shyndman/esp-theoretical-thermostat/openspec/changes/improve-audio-quality/specs/microphone-streaming/spec.md

## MODIFIED Requirements
### Requirement: Microphone Streaming Configuration
The system SHALL provide build-time settings that enable or disable microphone streaming and allow wiring adjustments for the PDM microphone.

#### Scenario: Menuconfig options available
- **WHEN** `CONFIG_THEO_CAMERA_ENABLE = y`
- **THEN** the "Camera & Streaming" menu exposes `CONFIG_THEO_MICROPHONE_ENABLE`, `CONFIG_THEO_MIC_PDM_CLK_GPIO`, and `CONFIG_THEO_MIC_PDM_DATA_GPIO`.
- **AND** disabling `CONFIG_THEO_MICROPHONE_ENABLE` omits microphone capture code and suppresses the audio track from the WebRTC offer.

#### Scenario: Default configuration values
- **WHEN** the firmware is built using the repository `sdkconfig.defaults`
- **THEN** `CONFIG_THEO_MICROPHONE_ENABLE` defaults to `n` until audio is validated on hardware
- **AND** the clock/data GPIO defaults remain 12 and 9 so existing harnesses require no extra wiring.

### Requirement: PDM Microphone Capture Path
When microphone streaming is enabled the firmware SHALL dedicate I2S0 to the MEMS PDM microphone, capture 16-bit mono PCM at 16 kHz, and feed 20 ms frames into the esp_capture pipeline.

#### Scenario: Hardware capture configured
- **WHEN** `CONFIG_THEO_MICROPHONE_ENABLE = y`
- **THEN** I2S0 is initialized in PDM RX mode with CLK on `CONFIG_THEO_MIC_PDM_CLK_GPIO` and DIN on `CONFIG_THEO_MIC_PDM_DATA_GPIO`
- **AND** the capture source produces signed 16-bit mono PCM frames at 16 kHz for downstream encoding.

#### Scenario: Frame cadence
- **WHEN** the capture pipeline requests microphone samples
- **THEN** the audio source emits 320-sample buffers (~20 ms at 16 kHz) so the Opus encoder receives consistent frame sizes without extra resampling stages.

#### Scenario: Mic disabled
- **WHEN** `CONFIG_THEO_MICROPHONE_ENABLE = n`
- **THEN** no I2S0/PDM hardware is initialized and the WebRTC publisher operates video-only.

### Requirement: WebRTC Audio Lifecycle
The WebRTC publisher SHALL stream live microphone audio over the advertised Opus track, keep audio/video lifecycles aligned, and isolate failures so video can continue if the mic breaks.

#### Scenario: Audio starts and stops with WebRTC
- **WHEN** the esp_webrtc peer connection transitions to CONNECTED and audio streaming is enabled
- **THEN** the esp_capture sink starts producing 16 kHz, 20 ms Opus frames, and the send-only audio track carries those samples until the peer disconnects
- **AND** when the peer disconnects the audio capture task stops, releases I2S0, and the Opus track is removed from SDP until audio is re-enabled.

#### Scenario: Failure isolation
- **WHEN** microphone initialization, capture, or Opus encoding fails while video is healthy
- **THEN** the firmware logs the error, keeps video streaming, and does not attempt to restart audio until the module is reinitialized (or the device reboots).

#### Scenario: Single publisher
- **WHEN** a second peer attempts to subscribe to the WebRTC stream
- **THEN** the system preserves the existing single-session behaviour (the first peer keeps audio/video, others are rejected) so bandwidth and heap usage remain bounded.
