shyndman/esp-theoretical-thermostat/openspec/changes/add-led-notifications/design.md

# Design: LED diffuser notifications

## Hardware / driver assumptions
- The strip is fifty WS2812-class pixels with an RGB subpixel layout. We will rely on Espressif's `led_strip` component (RMT backend) to generate the timings, configured for 10 MHz and GRB ordering on `CONFIG_THEO_LED_STRIP_GPIO` (default 33).
- The diffuser expects a uniform wash, so the driver always writes the same color to every pixel. This keeps RAM footprint tiny (one `led_strip_set_pixel` call per LED) and avoids needing animation buffers.
- Brightness is implicit in the provided RGB hex values; we scale them during fades by multiplying components before each refresh.

## Initialization order
- `thermostat_leds_init()` becomes the very first subsystem invoked inside `app_main`, before BSP display/touch setup, so the blue boot pulse serves as an immediate "sign of life" while the LCD stack is still configuring.
- If initialization succeeds and LEDs are enabled, `thermostat_led_status_booting()` starts the 0.33 Hz pulse immediately, bypassing quiet-hours checks until SNTP delivers time (defined as `time_sync_wait_for_sync(0)` returning true). Once the clock is accurate—or we exit boot without ever syncing—subsequent LED requests go through the shared quiet-hours helper.

## Service layers
1. **`thermostat_leds`**: owns initialization, enable flag, quiet-hours gating hooks, and primitive effects.
   - Effects:
     - `thermostat_leds_pulse(color, hz)`: sets a 50% duty oscillation implemented via an esp_timer (10 ms tick) that rewrites all pixels and calls `led_strip_refresh()` every tick.
     - `thermostat_leds_solid_fade(color, fade_ms)`: ramp from off to color across evenly spaced steps (≥10 per fade) before holding.
     - `thermostat_leds_off_fade(fade_ms)`: ramp from current color to off using the same stepping logic.
   - Any new effect call cancels the currently running timer/effect immediately before arming the replacement so controllers do not need to coordinate sequencing.
   - When LEDs are disabled or the quiet-hours helper denies output, the service short-circuits and reports the error so controllers can skip scheduling timers.
2. **`thermostat_led_status`**: high-level state machine that listens to boot lifecycle + HVAC dataplane events.
   - Boot path: `app_main` calls `thermostat_led_status_booting()` immediately after LED init (before LVGL) to begin the 0.33 Hz blue pulse; once the splash is destroyed it calls `thermostat_led_status_boot_complete()` to run the 1 s fade-up + hold + 100 ms fade-out.
  - HVAC path: MQTT dataplane toggles `thermostat_led_status_set_hvac(bool heating, bool cooling)` immediately after it updates the UI view-model (same callsite as `thermostat_update_hvac_status_group()`). Heating wins when both true (defensive), with cooling selected only when heating is false.
   - Idle/off: when no scenarios apply, LEDs fade off over 100 ms via `thermostat_leds_off_fade(100)`.

## Shared quiet-hours helper
- Introduce `main/thermostat/application_cues.{c,h}` with the API:
  - `esp_err_t thermostat_application_cues_check(const char *cue_name, bool feature_enabled);` → centralized helper that every "application cue" (user-facing audio/LED signal) calls to confirm it may run. It wraps the relevant build flag (`feature_enabled`), SNTP sync (via `time_sync_wait_for_sync(0)`), and quiet-window math (driven by neutral `CONFIG_THEO_QUIET_HOURS_START_MINUTE` / `_END_MINUTE`). Returns `ESP_OK` when cues may run, `ESP_ERR_NOT_SUPPORTED` when the build flag is off, and `ESP_ERR_INVALID_STATE` for quiet hours or unsynced clocks. `cue_name` is used in logs so suppression reasons stay readable.
  - Helper functions live alongside a static struct caching quiet-window config so audio and LEDs stop duplicating minute/interval math. There is no background polling—quiet hours are enforced strictly at request time.
- **Existing code changes:** `audio_boot.c` replaces `audio_policy_check()` with calls into `thermostat_application_cues_check("Boot chime", CONFIG_THEO_AUDIO_ENABLE)` so the quiet logic is centralized. The local helper functions (`quiet_hours_active`, `log_quiet_hours_skip`, etc.) move into `application_cues.c` along with the renamed neutral Kconfig symbols.
- **LED integration:** `thermostat_leds_*` APIs call the helper before arming timers once the clock is valid; if the helper returns non-OK they drop the request (leaving any existing effect untouched) and short-circuit. During early boot, LEDs bypass the helper so the blue pulse still runs, then opt into the helper as soon as `time_sync_wait_for_sync(0)` returns true (or boot exits after logging the sync failure).
- Quiet-hours configuration lives under the new neutral Kconfig entries shared by audio + LEDs, and there is no requirement to resume cues automatically when quiet hours end—the caller must issue a fresh request if it still wants output.

## Build flag behavior
- `CONFIG_THEO_LED_ENABLE` gates initialization entirely. When false, `thermostat_leds_init()` returns `ESP_ERR_NOT_SUPPORTED`, `thermostat_led_status_booting()` logs INFO that LEDs are disabled, and all subsequent requests become NOPs without allocating RAM or timers.

## Failure & recovery
- Driver init failures bubble up with `ESP_LOGE` but do not block boot; controllers treat LEDs as optional.
