shyndman/esp-theoretical-thermostat/docs/manual-test-plan.md

# Manual Test Plan

MQTT placeholders used below:
- `<HABase>` = normalized `CONFIG_THEO_HA_BASE_TOPIC` (blank falls back to `homeassistant`; trailing `/` is trimmed)
- `<TheoBase>` = normalized `CONFIG_THEO_THEOSTAT_BASE_TOPIC` (default `theostat`)
- `<TheoBase>/<slug>` = canonical Theo device root

## Dataplane Validation
1. Connect the thermostat to the Home Assistant broker specified by `CONFIG_THEO_MQTT_HOST` and ensure the dataplane subscriptions are accepted.
2. Drag either setpoint slider on the device and release to commit. Watch the serial log for the `temperature_command` JSON publish and note the QoS1 message id.
3. Verify via `mosquitto_sub -t "<TheoBase>/<slug>/climate/temperature_command" -v` (or the broker's MQTT debug console) that the publishes land; the thermostat updates immediately and no timeout rollback should occur.
4. Observe the UI to ensure slider positions, weather, room, and HVAC indicators match the inbound MQTT payloads; malformed payloads should log warnings and show the ERR/error-color states without crashing.

## Remote Setpoint Animation
1. Let the panel enter idle sleep, then publish a new `target_temp_high` (cooling) via MQTT while monitoring logs. Confirm the controller logs the wake request, backlight-light transition, 1000 ms pre-delay, and that both tracks/labels animate toward the new value over ~1600 ms while the numerals show intermediate temperatures.
2. While the first animation is running, publish at least two additional setpoint updates (mix of `target_temp_low/high`). Confirm only the latest payload per burst runs next, there is no extra pre-delay, and the logs note the pending-session handoffs.
3. After the final animation, ensure the log reports a 1000 ms hold followed by `backlight_manager_schedule_remote_sleep(...)` only if the first wake was consumed and no other touches occurred. Trigger a touch during the hold to verify the auto-sleep is skipped.

## Boot Transition & UI Entrance Animations
1. Reboot the thermostat and observe the boot ceremony: sparkle drain → LED white fade-in (1200 ms) → white hold (1200 ms) → LED black fade-out (2000 ms).
2. Verify the splash screen remains fully visible during the LED white fade-in and hold, then fades out in sync with the LED black fade-out over 2000 ms.
3. Confirm the main UI entrance begins ~400 ms before the splash fade completes: top bar fades in left-to-right (weather → HVAC → room), cooling track grows, heating track follows 400 ms later, labels fade in (whole then fractional), then action bar icons fade in (mode → power → fan).
4. During the entrance animation, attempt to drag setpoints and tap action bar icons; verify no interactions occur. Once the fan icon fade completes, verify touch input works normally.
5. Tap the inactive setpoint label and the mode icon to toggle active target; confirm both setpoint label/track colors smoothly transition over ~300 ms without blocking interaction.
6. Enable quiet hours (covering current time), reboot, and confirm the boot LED ceremony still runs while synced quiet-hours LED output is visibly dimmer than normal; the splash fade and UI entrance animations should remain unchanged.

## OTA Updates
1. Boot the thermostat and wait for the `OTA endpoint ready at http://<ip>:<port>/ota` log line.
2. Run `scripts/push-ota.sh` and confirm the OTA modal appears, the backlight stays on, the H.264 stream stops, and the device reboots after upload.
3. After reboot, confirm the log shows `[ota] running image marked valid` once the splash fades.
4. Verify missing length handling: `curl -X POST -H "Transfer-Encoding: chunked" http://<ip>:<port>/ota` returns HTTP 411.
5. Verify oversize handling: `dd if=/dev/zero of=/tmp/ota-oversize.bin bs=1M count=5` then `curl --data-binary @/tmp/ota-oversize.bin http://<ip>:<port>/ota` returns HTTP 413.

## Camera Streaming (WebRTC H.264 + Opus)
1. Wait for `WebRTC publisher started:` in the log; ensure the WHIP endpoint matches `CONFIG_THEO_WEBRTC_*` settings.
2. In go2rtc, verify the `thermostat` stream advertises `video: H264` and `audio: Opus` (16 kHz, mono). Example: `curl http://go2rtc/api/streams | jq '.thermostat.tracks'` should show `opus/16000/1` for audio.
3. Play the go2rtc stream with `ffplay rtsp://<go2rtc-host>:8554/thermostat` (or via the HA dashboard) and confirm room audio is audible without sustained silence or metallic artifacts.
4. Record a 15-second clip for ASR validation: `ffmpeg -i rtsp://<go2rtc-host>:8554/thermostat -map a -t 15 -c copy /tmp/thermostat_audio.opus`, then `ffmpeg -i /tmp/thermostat_audio.opus -ar 16000 -ac 1 -c:a pcm_s16le /tmp/thermostat_audio.wav` and feed it to the desktop ASR pipeline; capture WER/notes for the change record.
5. Disconnect the viewer and confirm the logs show `PeerConnectionState: disconnected` followed by `Stopping WebRTC publisher`; reconnect to ensure the session restarts automatically.
6. Attempt to start a second viewer while one is active; confirm go2rtc reports the thermostat stream as busy (single WebRTC session enforced) and the firmware keeps the first session running.
7. Temporarily build with `CONFIG_THEO_MICROPHONE_ENABLE=n` and confirm go2rtc now reports only the video track; verify the firmware logs that microphone streaming is disabled.

## Hundredth-Precision Setpoints
1. Wake the display and slowly drag each slider to land on a non-tenth value (e.g., 23.37 °C cooling, 21.82 °C heating). Watch the LVGL log for the `Committing setpoints` line and the `temperature_command` payload to confirm both emit two decimal places while the UI label continues to show tenths.
2. Publish `target_temp_high`/`target_temp_low` payloads that include hundredth precision (e.g., 25.55/22.15). Observe `[remote] animation started` logs to verify the controller accepts the hundredth value, and watch the animation to ensure the track motion appears continuous without 0.1 °C jumps while labels still round to tenths.

## LED Notifications & Quiet Hours
1. With `CONFIG_THEO_LED_ENABLE=y`, reboot the device and watch for the blue 0.33 Hz pulse immediately after reset plus the 1 s fade-up/hold/fade-down sequence once the splash dismisses. Confirm logs show `thermostat_led_status` transitions but boot continues even if LEDs fail.
2. Publish MQTT HVAC payloads (heat/cool) after the UI loads and confirm the diffuser switches to the specified colors (`#e1752e` heat, `#2776cc` cool) pulsing at 1 Hz; clear both states to verify a 100 ms fade-to-black. When LEDs are disabled via `CONFIG_THEO_LED_ENABLE=n`, confirm these requests log INFO about the kill switch without blocking boot.
3. Set `CONFIG_THEO_QUIET_HOURS_START_MINUTE`/`END_MINUTE` to cover the current local time, reboot, and wait for SNTP sync. Verify that new LED cues (heating/cooling, bias lighting, or timed effects) still start after sync but render at clearly reduced brightness (~25% of normal) without WARN suppression logs for quiet hours. Also confirm the blue boot pulse still runs before the clock syncs and that once `thermostat_led_status_boot_complete()` fires, the quiet-hours brightness policy applies to subsequent requests.

## Scott Greeting Cues
1. Publish retained `<HABase>/sensor/hallway_camera_last_recognized_face/state` and `.../person_count/state` payloads (`Scott` and `0` respectively), then send a live `person_count` of `2` followed by a non-retained `Scott` face. Confirm the first payload is ignored, the live detection triggers exactly one greeting, and logs show both audio + LED cues.
2. Publish `<HABase>/sensor/hallway_camera_person_count/state` with `unavailable`, then send `Scott`. Verify WARN logs indicate suppression and no cue fires until a numeric count ≥1 arrives; after sending `1`, resend `Scott` and expect the greeting to run.
3. Force quiet hours (either via config or local time) and trigger a `Scott` detection after SNTP sync. Confirm the audio subsystem logs suppression immediately while the LED greeting still runs at visibly reduced brightness (~25% of normal), and verify the helper resets so the next detection after quiet hours can run.
4. Start a conflicting LED effect (e.g., `rainbow` command) and then send `Scott`. Verify LED status logs a busy warning, the helper completes immediately, and audio still plays if permitted.
5. Build with `CONFIG_THEO_AUDIO_ENABLE=n`, trigger `Scott`, and confirm the helper logs an audio-disabled INFO but LEDs still run (including quiet-hours dimming when applicable). Re-enable audio afterward.
6. Remove or rename `assets/audio/scott_greeting.wav` and run `scripts/generate_sounds.py`; confirm the script/build fails, documenting that the asset is required before attempting to flash.

## Environmental Telemetry

### Configuration Defaults
- `CONFIG_THEO_DEVICE_SLUG`: default `hallway`
- `CONFIG_THEO_DEVICE_FRIENDLY_NAME`: blank (auto-derives from slug as "Hallway")
- `CONFIG_THEO_THEOSTAT_BASE_TOPIC`: default `theostat`
- Canonical Theo device root: `<TheoBase>/<slug>` (default `theostat/hallway`)
- `CONFIG_THEO_I2C_ENV_SDA_GPIO`: 7
- `CONFIG_THEO_I2C_ENV_SCL_GPIO`: 8
- `CONFIG_THEO_SENSOR_POLL_SECONDS`: 5
- `CONFIG_THEO_SENSOR_FAIL_THRESHOLD`: 3

### Boot & Sensor Initialization
1. Boot the thermostat with AHT20 and BMP280 sensors connected to GPIO7 (SDA) and GPIO8 (SCL). Confirm the splash screen shows "Starting environmental sensors..." and progresses past this stage without error.
2. Disconnect either sensor and reboot. Verify the boot halts at "start environmental sensors" with an error displayed on the splash screen.
3. After successful boot, check serial logs for `[env_sensors] AHT20 initialized` and `[env_sensors] BMP280 initialized` messages.

### MQTT Telemetry Publishing
1. Subscribe to `<TheoBase>/<slug>/sensor/#` using mosquitto_sub and verify:
   - Four state topics are published: `temperature_bmp/state`, `temperature_aht/state`, `relative_humidity/state`, `air_pressure/state`
   - Values are numeric with two decimal places
   - Messages are retained (QoS0)
2. Wait for `CONFIG_THEO_SENSOR_POLL_SECONDS` (default 5s) and confirm new values are published.
3. Keep `mosquitto_sub -v` running on the environmental topics above plus the radar topics `<TheoBase>/<slug>/binary_sensor/radar_presence/#` and `<TheoBase>/<slug>/sensor/radar_distance/#` so late-connect and reconnect behavior is visible without guessing.

### Environmental + Radar Availability / Reconnect Scenarios
Use `mosquitto_sub -v -t '<TheoBase>/#'` or equivalent filtered subscriptions. The key topics to watch are:
- Device-level availability: `<TheoBase>/<slug>/availability`
- Environmental state: `<TheoBase>/<slug>/sensor/temperature_bmp/state`, `.../temperature_aht/state`, `.../relative_humidity/state`, `.../air_pressure/state`
- Environmental per-entity availability: `<TheoBase>/<slug>/sensor/temperature_bmp/availability`, `.../temperature_aht/availability`, `.../relative_humidity/availability`, `.../air_pressure/availability`
- Radar state: `<TheoBase>/<slug>/binary_sensor/radar_presence/state`, `<TheoBase>/<slug>/sensor/radar_distance/state`
- Radar per-entity availability: `<TheoBase>/<slug>/binary_sensor/radar_presence/availability`, `<TheoBase>/<slug>/sensor/radar_distance/availability`
- Discovery: `<HABase>/sensor/<slug>/+/config`, `<HABase>/binary_sensor/<slug>-theostat/+/config`, `<HABase>/sensor/<slug>-theostat/+/config`

1. Late broker connect / reconnect:
   - Boot the thermostat with the broker unavailable, then bring MQTT up after environmental sensors and radar are already producing data.
   - Confirm `<TheoBase>/<slug>/availability` flips to retained `online` when MQTT connects; that topic is the device-level truth and should not flap because one sensor is unhealthy.
   - On the same connect, confirm retained discovery republishes for all environmental and radar entities before or alongside their retained availability/state so Home Assistant can rehydrate cleanly.
   - Confirm each environmental entity republishes its own retained availability (`online` for healthy sensors, `offline` for failed ones) and any valid cached retained state. Confirm radar does the same for `radar_presence` and `radar_distance` if the radar has valid cached data.
   - Repeat by disconnecting and reconnecting the broker after the device has been running for at least one polling interval; expect the same coherent republish behavior on every reconnect.

2. Radar failure while thermostat stays connected:
   - Keep Wi-Fi and MQTT connected, then force radar frame timeouts until `CONFIG_THEO_RADAR_FAIL_THRESHOLD` is exceeded.
   - Confirm `<TheoBase>/<slug>/availability` stays retained `online` throughout.
   - Confirm only `<TheoBase>/<slug>/binary_sensor/radar_presence/availability` and `<TheoBase>/<slug>/sensor/radar_distance/availability` switch to retained `offline`, with the log showing `Radar marked offline after N consecutive timeouts`.
   - Confirm environmental availability/state topics continue updating normally while radar entities are offline.

3. Device disappearance / MQTT LWT:
   - Power off the thermostat, crash it, or otherwise sever it from the broker so the MQTT last-will fires.
   - Confirm `<TheoBase>/<slug>/availability` changes to retained `offline`.
   - Confirm this is the condition that should make the Home Assistant device appear unavailable; do not expect per-entity availability topics to simulate a full device disappearance on their own.

4. Radar recovery:
   - Restore the radar after the failure case above.
   - Confirm `<TheoBase>/<slug>/availability` remains `online` the whole time.
   - Confirm radar logs `Radar now online`, then republish retained `online` on both radar availability topics, followed by valid retained `radar_presence/state` (`ON`/`OFF`) and `radar_distance/state` values once fresh frames arrive.
   - Confirm environmental entities are unaffected by the radar recovery path.

### Home Assistant Discovery
1. Subscribe to `<HABase>/sensor/<slug>/+/config` and verify four discovery payloads are published with correct:
   - `device_class`, `state_class`, `unit_of_measurement`
   - `unique_id` format: `theostat_<slug>_<object_id>`
   - `state_topic` and `availability_topic` paths
   - `device` block with `name`, `identifiers`, `manufacturer`, `model`
2. Also verify radar discovery lands on `<HABase>/binary_sensor/<slug>-theostat/radar_presence/config` and `<HABase>/sensor/<slug>-theostat/radar_distance/config`, and that each payload includes both the shared device availability topic (`<TheoBase>/<slug>/availability`) and its own per-entity availability topic.
3. In Home Assistant, navigate to Settings > Devices & Services > MQTT and confirm the thermostat device appears as one device containing all four environmental sensors plus the radar entities.

### Temperature Command Topic Migration
1. Adjust a setpoint slider and release. Verify the command publishes to `<TheoBase>/<slug>/climate/temperature_command` (not the old HA base topic).
2. Check logs for `temperature_command msg_id=X topic=theostat/hallway/climate/temperature_command` (or the configured `<TheoBase>/<slug>`).
3. Confirm the UI still receives remote setpoint updates via the existing HA topic subscriptions.

## Presence Hold Cap
1. Set `CONFIG_THEO_BACKLIGHT_PRESENCE_MAX_SECONDS=60` for a quicker run.
2. Let the display sleep, then approach within wake distance and confirm presence wake.
3. Stay in place and wait for the cap; confirm logs show the hold exceeded message and the screen turns off.
4. Remain present and verify the screen stays off (presence ignored).
5. Step away until presence clears, then re-approach and confirm presence wake works again.
6. Repeat with a touch interaction ~40 seconds in to confirm the cap timer resets and extends the on duration.

## Transport Monitor (Wi-Fi SDIO Stats)

### Prerequisites
- Enable `CONFIG_THEO_TRANSPORT_MONITOR=y` in sdkconfig.
- Default `CONFIG_THEO_TRANSPORT_MONITOR_PERIOD_MS=3000` (3 seconds).

### Log Validation
1. Boot the thermostat and wait for Wi-Fi connection (`IP_EVENT_STA_GOT_IP`).
2. Observe serial logs for `transport_monitor: Transport monitor started (period=3000ms)`.
3. After the first 3-second interval, verify a log line appears: `transport_monitor: tx=<N> p/s rx=<N> p/s drop=<N> p/s flowctl=<on>/<off> throttling=<yes|no> (period=3000ms)`.
4. Walk the device around to vary signal strength; confirm TX/RX rates change in subsequent log lines.
5. Induce interference (e.g., microwave oven, faraday cage) and watch for flow-control toggle counts (`flowctl=<on>/<off>`) to increase and `throttling=yes` to appear.

### Overlay Validation (Visible Mode)
1. Ensure `CONFIG_THEO_TRANSPORT_MONITOR_LOG_ONLY=n` (default).
2. After the UI attaches, confirm a small semi-opaque label appears in the bottom-left corner.
3. Verify the overlay text format matches:
   - Line 1: `TX <N> p/s   RX <N> p/s`
   - Line 2: `Drop <N> p/s   FlowCtl <on>/<off>`
4. Move the device and confirm overlay values update within ~100 ms of each log line.
5. The overlay styling should match LVGL sysmon: semi-opaque black background, white text, 3 px padding.

### Log-Only Mode Validation
1. Rebuild with `CONFIG_THEO_TRANSPORT_MONITOR_LOG_ONLY=y`.
2. Boot and confirm the overlay does NOT appear on screen.
3. Verify logs still emit the transport stats every 3 seconds as before.

### Wi-Fi Disconnect/Reconnect
1. While monitoring is active, disconnect the Wi-Fi AP (or use `WIFI_EVENT_STA_DISCONNECTED` trigger).
2. Confirm logs show `transport_monitor: Transport monitor stopped`.
3. Reconnect Wi-Fi; confirm `transport_monitor: Transport monitor started` appears and the first interval after reconnect is treated as a priming sample (no stats logged until the second interval).

## Stack and Heap Observability (Phase 2)

### Scope
- Validate OBS-01 through OBS-04 using local serial logs only.
- Do not use MQTT publish paths, Home Assistant entities, or external telemetry for this section.

### Baseline Structured Runtime-Health Logs
1. Build and flash current firmware, then open serial monitor.
2. Wait for `runtime health initialized`, then watch for periodic `runtime_health_obs` lines from `runtime_health`.
3. Confirm each structured line includes stack headroom + level for all required probes:
   - `stack_mqtt_headroom_b` / `stack_mqtt_level`
   - `stack_env_headroom_b` / `stack_env_level`
   - `stack_webrtc_headroom_b` / `stack_webrtc_level`
   - `stack_radar_headroom_b` / `stack_radar_level`
4. Confirm each structured line includes internal-RAM heap fields:
   - `heap_internal_free_b`
   - `heap_internal_min_b`
   - `heap_internal_largest_b`
   - `heap_internal_ratio_permille`
   - `heap_internal_risk`

### OBS-01 Coverage Checks (mqtt/env/webrtc/radar)
1. MQTT dataplane + env sensors: verify non-zero stack samples appear after normal boot/runtime traffic.
2. WebRTC worker: start a WHEP session and confirm subsequent `runtime_health_obs` lines show `stack_webrtc_headroom_b` with live values (not permanently zero).
3. Radar-start path: reboot and confirm `stack_radar_headroom_b` appears in the periodic line after boot (captured from self-report before task exit).
4. Optional non-WebRTC build check: build with WebRTC disabled and confirm firmware still boots and logs keep WebRTC fields present without crashes.

### Threshold Transition + Hysteresis Validation (OBS-02 / OBS-04)
1. Watch for transition lines formatted as `runtime_health_transition` for both domains:
   - stack: `domain=stack probe=<name> from=<level> to=<level>`
   - heap: `domain=heap scope=internal from=<level> to=<level>`
2. Trigger WARN/CRIT crossings with controlled stress:
   - Stack: run sustained workload (for example active streaming + UI interaction) until at least one stack probe transitions to WARN or CRIT.
   - Heap: run sustained allocation-heavy workload (for example repeated stream setup/teardown) until heap transitions to WARN or CRIT.
3. Confirm clear behavior is hysteresis-preserving:
   - After stress is removed, levels should not instantly clear on a single good sample.
   - A clear transition should eventually appear (`to=OK`) once values remain above clear thresholds.
4. If thresholds are difficult to cross on production defaults, use a temporary validation build with tighter `runtime_health.c` thresholds, verify transitions/clears, then restore defaults before shipping.

### Pass Criteria
1. Periodic structured runtime-health log is present and parseable from serial output.
2. Required OBS probe paths (`mqtt`, `env`, `webrtc`, `radar`) are visible in runtime-health output.
3. WARN/CRIT and clear transitions are observable in serial logs for both stack and heap domains.
4. Validation is completed without relying on MQTT/HA publication paths.

## Phase 2.1 Wave-1 (WebRTC) Validation

### Scope and Acceptance
- Validate the wave-1 WebRTC tuning bundle with required scenarios: boot + idle + touchscreen + one WebRTC session start/stop.
- Acceptance remains human sign-off only; this section defines evidence capture and rejection notes.

### Build Variants
1. Baseline build: keep `CONFIG_THEO_RAM_WAVE1_WEBRTC_TUNING` disabled.
2. Wave-1 build: enable `CONFIG_THEO_RAM_WAVE1_WEBRTC_TUNING=y`.
3. For each variant, capture at least one periodic `runtime_health_ram_attr` line from serial logs.

### Required Scenario Steps (run for both variants)
1. Boot to main UI and wait at least 60 seconds idle so periodic `runtime_health_ram_attr` appears.
2. Perform touchscreen interaction (drag setpoint, toggle mode once) and verify UI remains responsive.
3. Start one WebRTC session through WHEP/go2rtc, keep it active for at least 30 seconds, then stop/disconnect cleanly.
4. After stream stop, wait for next periodic attribution line and capture churn deltas.

### Required Contract Checks
1. **Network:** Wi-Fi connected (`IP_EVENT_STA_GOT_IP` and no persistent disconnect loop).
2. **MQTT:** dataplane connected/subscribed and setpoint command publish still works.
3. **Display:** panel rendering quality unchanged (no downgraded resolution/format artifacts).
4. **Touchscreen:** touch interactions still register and complete without freezes.

### Evidence to Capture
1. `runtime_health_ram_attr` keys present: `display_lvgl_b`, `webrtc_pool_cache_b`, `mqtt_queue_est_b`, `stack_budget_b`, `dyn_webrtc_alloc_delta`, `dyn_whep_alloc_delta`.
2. `webrtc_wave1` is `0` for baseline and `1` for tuned build.
3. Any regression in required contract checks, including whether a reboot-and-retry reproduces it.

### Failure Note Template (use when rejecting a bundle)
```
Wave: 2.1-wave1-webrtc
Build flag: CONFIG_THEO_RAM_WAVE1_WEBRTC_TUNING=[y|n]
Scenario step: [boot|idle|touch|stream_start|stream_stop]
Observed failure: [what broke]
Required contract impact: [network|mqtt|display|touchscreen]
Repro after one retry: [yes|no]
Evidence: [key log lines and timestamps]
Disposition: [rejected for this wave | needs follow-up tuning]
```

## Phase 1 Memory-Safe MQTT Reassembly
1. Start with a clean boot and wait for at least one `mqtt_digest` line. Verify it is one structured `key=value` `ESP_LOGI` line and includes both total and delta fields for `drop_oversize`, `drop_out_of_order`, `drop_nonzero_first`, `drop_overlap`, `drop_queue_full`, and `preempted`.
2. Valid in-order reassembly case: publish a payload split into ordered fragments with `offset` values `0`, then increasing contiguous offsets, total <= 1024 bytes. Verify the payload is processed once, and the next digest shows `accepted_delta` and `complete_delta` increased while all drop deltas stay at `0`.
3. Oversize case: publish fragmented traffic with `total_data_len > 1024` or a fragment where `offset + fragment_len > total_data_len`. Verify each drop logs exactly one reason `reason=oversize`, and the next digest increments only `drop_oversize_delta`.
4. Out-of-order case: start a valid fragmented flow, then send a fragment with a gap in offset (`offset` greater than expected contiguous position). Verify each rejected fragment logs exactly one reason `reason=out_of_order`, and the next digest increments only `drop_out_of_order_delta`.
5. Nonzero-first case: send a first fragment with `offset > 0` while no active reassembly exists. Verify each rejected fragment logs exactly one reason `reason=nonzero_first`, and the next digest increments only `drop_nonzero_first_delta`.
6. Overlap freshness-first preemption case: while one valid fragmented flow is active, send a valid newcomer first fragment (`offset=0` with topic metadata). Verify the old flow is preempted, log contains `preempt active flow`, and next digest increments `preempted_delta`; then send a stale old-flow fragment and verify exactly one `reason=overlap` drop with only `drop_overlap_delta` incremented.
7. Queue-full case: create sustained burst traffic that saturates dataplane queue depth. Verify each rejected enqueue logs exactly one reason `reason=queue_full`, and the next digest increments only `drop_queue_full_delta` for those drops.
8. Heartbeat case: after traffic stops, wait a full minute and confirm another `mqtt_digest` line still prints with all `*_delta=0` values while totals remain cumulative.
