shyndman/esp-theoretical-thermostat/openspec/changes/archive/2026-01-29-stream-it-faster/tasks.md

## 1. Implementation
- [x] 1.1 Add `Camera & Streaming -> WebRTC` Kconfig entries (`CONFIG_THEO_WEBRTC_ENABLE`, `HOST`, `PORT`, `PATH`, `STREAM_ID`) plus matching defaults in `sdkconfig.defaults` so LAN builds point to go2rtc without manual edits.
- [x] 1.2 Port the `@tmp/doorbell_demo` media glue into `main/streaming/` (esp_capture setup, av_render, media provider) and strip doorbell-specific UI/audio so it captures OV5647 frames only.
- [x] 1.3 Replace AppRTC signaling with `esp_signaling_get_whip_impl()`, sourcing `signaling_cfg.signal_url` from the new Kconfig and ensuring only POST/DELETE are emitted (disable trickle ICE/PATCH paths).
- [x] 1.4 Configure the peer for host-only ICE (`ice_trans_policy`, no STUN/TURN) and video-only tracks (`video_dir = SEND_ONLY`, `audio_dir = NONE`, H.264 1280x960@10fps) using the esp_capture provider.
- [x] 1.5 Remove `mjpeg_stream.c`, `streaming_state.{c,h}`, and their build entries (from `main/CMakeLists.txt`); swap `app_main.c`/`ota_start_cb` to call the new WebRTC start/stop hooks instead of MJPEG.
- [x] 1.6 Wire `ESP_WEBRTC_EVENT_CONNECTED`/`DISCONNECTED` callbacks to `thermostat_ir_led_set()` so the LED mirrors connection state instead of HTTP client counts.
- [x] 1.7 Add WARN-level logging for WHIP POST failures, HTTP status codes, and auto-reconnect attempts to aid troubleshooting.
- [x] 1.8 Update documentation/Frigate instructions to reference the WebRTC publisher via go2rtc rather than `/video`.

## 2. Validation
- [x] 2.1 Run `idf.py build` (with default sdkconfig) to confirm esp_webrtc/esp_capture dependencies resolve.
- [x] 2.2 Connect to a local go2rtc instance, verify sub-second playback via browser/Frigate, and confirm IR LED toggles with connection state.
- [x] 2.3 Restart go2rtc (or cycle network) to ensure the publisher auto-reconnects and logs lifecycle transitions.
- [x] 2.4 Re-run `openspec validate stream-it-faster --strict` after implementation.
