shyndman/esp-theoretical-thermostat/openspec/changes/archive/2026-01-18-create-stream-after-connect/tasks.md

## 1. Implementation
- [x] 1.1 Add stream lifecycle state in `main/streaming/h264_stream.c`: reuse `s_streaming` as the client-active flag, add `s_pipeline_active` + `s_pipeline_failed`, and add `s_stream_mutex` (`SemaphoreHandle_t`) created with `xSemaphoreCreateMutex()` (pattern in `main/sensors/env_sensors.c`).
- [x] 1.2 Extract `start_pipeline()` to call `init_ldo()` → `init_video_subsystem()` (only when `s_video_initialized` is false) → `init_v4l2_capture()` → `init_h264_encoder()`; on any failure call `stop_pipeline()` to unwind partial setup, set `s_pipeline_failed = true`, and return the error.
- [x] 1.3 Extract `stop_pipeline()` to stop V4L2 streams, unmap buffers, close FDs, release the LDO, reset all buffer pointers/state flags except `s_pipeline_failed`, and keep `s_video_initialized` true (no `esp_video_deinit()`).
- [x] 1.4 Update `h264_stream_start()` to only start the HTTP server, initialize the mutex/state, and log that the stream server is ready; do not initialize the pipeline or reset `s_video_initialized`.
- [x] 1.5 Update `stream_handler()` to acquire the mutex, reject requests if `s_pipeline_failed` or `s_streaming` by calling `httpd_resp_set_status(req, "503 Service Unavailable")` and `httpd_resp_send(req, NULL, 0)` (no body; `esp_http_server.h` does not define `HTTPD_503`), otherwise set `s_streaming = true` and call `start_pipeline()` before responding with `Content-Type: video/h264`.
- [x] 1.6 On pipeline init failure in `stream_handler()`, clear `s_streaming`, keep `s_pipeline_failed = true`, release the mutex, and respond with `httpd_resp_set_status("503 Service Unavailable")` + `httpd_resp_send(req, NULL, 0)`.
- [x] 1.7 On client disconnect (`httpd_resp_send_chunk` failure or loop exit), stop the pipeline immediately, clear `s_streaming`, and log pipeline shutdown alongside the existing "Stream client disconnected" message.
- [x] 1.8 Update `h264_stream_stop()` to stop the HTTP server, call `stop_pipeline()` if active, destroy the mutex, and reset per-session state while keeping `s_video_initialized` true.
- [x] 1.9 Update `main/app_main.c` boot-stage text from "Starting H.264 stream…" to "Starting H.264 stream server…" and ensure log messaging distinguishes server start from pipeline start.
- [x] 1.10 Add a "Camera Streaming (H.264)" section after "Boot Transition & UI Entrance Animations" in `docs/manual-test-plan.md` with numbered steps: wait for the `H.264 stream available at http://<ip>:<port>/stream` log, connect to `/stream` and observe `Stream client connected`, disconnect to observe `Stream client disconnected` + pipeline stop log, and open a second client to confirm HTTP 503 with no body.

## 2. Validation
- [x] 2.1 Run `idf.py build`.
- [x] 2.2 On hardware, connect to `/stream` (port from `CONFIG_THEO_H264_STREAM_PORT`) to confirm the stream starts on connect, disconnect to confirm immediate pipeline shutdown, reconnect to confirm streaming resumes without `esp_video_init` failure, and open a second client to verify HTTP 503 with no response body.
