shyndman/esp-theoretical-thermostat/openspec/changes/archive/2026-01-18-replace-mjpeg-with-h264-streaming/tasks.md

## 1. Implementation
- [x] 1.1 Rename streaming Kconfig symbols to `THEO_H264_STREAM_PORT` and `THEO_H264_STREAM_FPS`, and remove JPEG quality settings.
- [x] 1.2 Replace MJPEG encoder path with H.264 M2M on `/dev/video11`, configuring YUV420 input at 800x800.
- [x] 1.3 Update the HTTP streaming handler to emit raw Annex-B H.264 with `Content-Type: video/h264` on `/stream`.
- [x] 1.4 Update boot messaging and any MJPEG-specific identifiers to H.264 equivalents.

## 2. Validation
- [x] 2.1 Run `idf.py build`.
