shyndman/esp-theoretical-thermostat/main/thermostat/thermostat_leds.c

#include "thermostat/thermostat_leds.h"

#include <math.h>
#include <stdio.h>
#include <string.h>

#include "connectivity/time_sync.h"
#include "esp_check.h"
#include "esp_log.h"
#include "esp_random.h"
#include "esp_timer.h"
#include "led_strip.h"
#include "sdkconfig.h"
#include "thermostat/application_cues.h"

#ifndef LED_PI
#define LED_PI 3.14159265f
#endif

#define THERMOSTAT_LED_COUNT        (39)
#define LED_TIMER_PERIOD_US         (10000)  // 10 ms tick
#define LED_TIMER_PERIOD_MS         (LED_TIMER_PERIOD_US / 1000)
#define LED_MIN_FADE_DURATION_MS    (100)
#define LED_PULSE_INTENSITY_SCALE   (0.4f)
#define LED_SPARKLE_TICKS_PER_FRAME (2)
#define LED_SPARKLE_FADE_BY         (9)
#define LED_SPARKLE_MAX_SPARKLES    (4)
#define LED_SPARKLE_SPAWN_PROB      (15)
#define LED_SPARKLE_SAT_MIN         (90)
#define LED_SPARKLE_SAT_MAX         (160)
#define LED_SPARKLE_INTENSITY_SCALE (100)

#define LED_GREETING_SWEEP_MS       (400)
#define LED_GREETING_PASSES         (6)
#define LED_GREETING_BAND_WIDTH     (4)
#define LED_GREETING_TAIL_DECAY     (0xC0)
#define LED_GREETING_BRIGHTNESS     (0.7f)
#define LED_QUIET_HOURS_BRIGHTNESS  (0.25f)

// Rainbow parameters (from scratch/rainbow_loop)
#define LED_RAINBOW_HUE_SPEED       (2)
#define LED_RAINBOW_HUE_DENSITY     (7)

// Wave parameters (from scratch/rising_warmth)
#define LED_WAVE_COUNT              (2)
#define LED_WAVE_WIDTH              (0.45f)
#define LED_WAVE_SPEED              (0.006f)
#define LED_WAVE_PULSE_BRIGHTNESS   (70)

// U-shape layout constants
#define LED_LEFT_START              (0)
#define LED_LEFT_END                (14)
#define LED_TOP_START               (15)
#define LED_TOP_END                 (22)
#define LED_RIGHT_START             (23)
#define LED_RIGHT_END               (38)

typedef enum {
  LED_EFFECT_IDLE = 0,
  LED_EFFECT_PULSE,
  LED_EFFECT_FADE,
  LED_EFFECT_SPARKLE,
  LED_EFFECT_RAINBOW,
  LED_EFFECT_WAVE,
  LED_EFFECT_GREETING,
} led_effect_type_t;

typedef struct {
  thermostat_led_color_t color;
  float hz;
  int64_t start_time_us;
} pulse_state_t;

typedef enum {
  LED_EASING_LINEAR = 0,
  LED_EASING_EASE_OUT,
  LED_EASING_EASE_IN,
} led_easing_t;

typedef struct {
  thermostat_led_color_t color;
  float start_brightness;
  float target_brightness;
  int64_t start_time_us;
  int64_t duration_us;
  led_easing_t easing;
} fade_state_t;

typedef struct {
  led_strip_handle_t strip;
  esp_timer_handle_t timer;
  led_effect_type_t effect;
  pulse_state_t pulse;
  fade_state_t fade;
  struct {
    thermostat_led_color_t pixels[THERMOSTAT_LED_COUNT];
    uint8_t tick_accumulator;
    bool stop_requested;
  } sparkle;
  struct {
    uint8_t hue_offset;
  } rainbow;
  struct {
    thermostat_led_color_t base_color;
    float wave_positions[LED_WAVE_COUNT];
    bool rising;  // true = rising (heat), false = falling (cool)
  } wave;
  struct {
    thermostat_led_color_t pixels[THERMOSTAT_LED_COUNT];
    float head_index;
    float step;
    int direction;
    uint8_t loops_remaining;
  } greeting;
  thermostat_led_color_t latched_color;
  float latched_brightness;
  bool initialized;
  bool available;
  bool quiet_gate_active;
} thermostat_led_runtime_t;

static thermostat_led_runtime_t s_leds = {0};
static const char *TAG = "thermo_leds";

static void led_effect_timer(void *arg);
static esp_err_t write_fill(thermostat_led_color_t color, float brightness);
static esp_err_t write_pixels(const thermostat_led_color_t *pixels, float brightness);
static void cancel_current_effect(void);
static bool cue_gate_required(void);
static esp_err_t guard_output(const char *cue_name);
static float apply_output_brightness_policy(float brightness);
static void sparkle_reset(void);
static void update_sparkle(void);
static void sparkle_fade_pixels(void);
static void sparkle_spawn_pixels(void);
static bool sparkle_is_dark(void);
static uint8_t random_u8(void);
static uint8_t random_u8_range(uint8_t min_inclusive, uint8_t max_exclusive);
static uint16_t random_pixel_index(void);
static thermostat_led_color_t sparkle_random_color(void);
static thermostat_led_color_t hsv_to_rgb(uint8_t hue, uint8_t saturation, uint8_t value);
static uint8_t scale8(uint8_t value, uint8_t scale);
static uint8_t scale8_video(uint8_t value, uint8_t scale);
static uint8_t saturating_add(uint8_t a, uint8_t b);
static void update_rainbow(void);
static void update_wave(void);
static void greeting_reset(void);
static void update_greeting(void);
static void greeting_fade_pixels(void);
static void greeting_paint_band(void);
static float greeting_step(void);

static float clamp_unit(float value)
{
  if (value < 0.0f)
  {
    return 0.0f;
  }
  if (value > 1.0f)
  {
    return 1.0f;
  }
  return value;
}

static float apply_easing(float t, led_easing_t easing)
{
  t = clamp_unit(t);
  switch (easing)
  {
    case LED_EASING_EASE_OUT:
    {
      float inv = 1.0f - t;
      return 1.0f - (inv * inv);
    }
    case LED_EASING_EASE_IN:
    {
      return t * t;
    }
    default:
      return t;
  }
}

static void ensure_timer_created(void)
{
  if (s_leds.timer)
  {
    return;
  }

  const esp_timer_create_args_t args = {
      .callback = led_effect_timer,
      .name = "led_effect",
  };
  if (esp_timer_create(&args, &s_leds.timer) != ESP_OK)
  {
    ESP_LOGE(TAG, "Failed to create LED effect timer");
  }
}

static void stop_timer(void)
{
  if (s_leds.timer)
  {
    esp_timer_stop(s_leds.timer);
  }
}

static void start_timer(void)
{
  ensure_timer_created();
  if (!s_leds.timer)
  {
    return;
  }
  esp_err_t err = esp_timer_start_periodic(s_leds.timer, LED_TIMER_PERIOD_US);
  if (err != ESP_OK && err != ESP_ERR_INVALID_STATE)
  {
    ESP_LOGW(TAG, "Failed to start LED timer (%s)", esp_err_to_name(err));
  }
}

static void cancel_current_effect(void)
{
  led_effect_type_t previous = s_leds.effect;
  stop_timer();
  s_leds.effect = LED_EFFECT_IDLE;
  if (previous == LED_EFFECT_SPARKLE)
  {
    sparkle_reset();
  }
}

static bool cue_gate_required(void)
{
  if (!s_leds.quiet_gate_active && time_sync_wait_for_sync(0))
  {
    s_leds.quiet_gate_active = true;
    ESP_LOGI(TAG, "SNTP synchronized; LED quiet-hours dimming now enforced");
  }
  return s_leds.quiet_gate_active;
}

static void format_cue_desc(char *buffer, size_t len, const char *label, thermostat_led_color_t color)
{
  if (!buffer || len == 0)
  {
    return;
  }
  snprintf(buffer, len, "%s #%02x%02x%02x", label, color.r, color.g, color.b);
}

static esp_err_t guard_output(const char *cue_name)
{
  if (!s_leds.available)
  {
    return ESP_ERR_INVALID_STATE;
  }

  if (!CONFIG_THEO_LED_ENABLE)
  {
    if (!cue_name)
    {
      cue_name = "LED cue";
    }
    ESP_LOGI(TAG, "%s suppressed: feature disabled", cue_name);
    return ESP_ERR_NOT_SUPPORTED;
  }

  if (!cue_gate_required())
  {
    return ESP_OK;
  }

  esp_err_t quiet_state = thermostat_application_cues_quiet_hours_active(NULL);
  if (quiet_state == ESP_ERR_INVALID_STATE)
  {
    if (!cue_name)
    {
      cue_name = "LED cue";
    }
    ESP_LOGW(TAG, "%s suppressed: clock unsynchronized; waiting for SNTP", cue_name);
  }
  return quiet_state;
}

static float apply_output_brightness_policy(float brightness)
{
  brightness = clamp_unit(brightness);

  if (!cue_gate_required())
  {
    return brightness;
  }

  bool quiet_hours_active = false;
  esp_err_t quiet_state = thermostat_application_cues_quiet_hours_active(&quiet_hours_active);
  if (quiet_state != ESP_OK || !quiet_hours_active)
  {
    return brightness;
  }

  return clamp_unit(brightness * LED_QUIET_HOURS_BRIGHTNESS);
}

static uint8_t random_u8(void)
{
  return (uint8_t)(esp_random() & 0xFF);
}

static uint8_t random_u8_range(uint8_t min_inclusive, uint8_t max_exclusive)
{
  uint8_t span = max_exclusive - min_inclusive;
  if (span == 0)
  {
    return min_inclusive;
  }
  return (uint8_t)(min_inclusive + (esp_random() % span));
}

static uint16_t random_pixel_index(void)
{
  if (THERMOSTAT_LED_COUNT == 0)
  {
    return 0;
  }
  return (uint16_t)(esp_random() % THERMOSTAT_LED_COUNT);
}

static uint8_t scale8(uint8_t value, uint8_t scale)
{
  return (uint8_t)(((uint16_t)value * (uint16_t)scale) >> 8);
}

static uint8_t scale8_video(uint8_t value, uint8_t scale)
{
  if (value == 0 || scale == 0)
  {
    return 0;
  }
  uint16_t product = ((uint16_t)value * (uint16_t)scale) >> 8;
  product += 1;  // video scaling keeps low values visible
  if (product > 255)
  {
    product = 255;
  }
  return (uint8_t)product;
}

static uint8_t saturating_add(uint8_t a, uint8_t b)
{
  uint16_t sum = (uint16_t)a + (uint16_t)b;
  if (sum > 255)
  {
    sum = 255;
  }
  return (uint8_t)sum;
}

static thermostat_led_color_t hsv_to_rgb(uint8_t hue, uint8_t saturation, uint8_t value)
{
  thermostat_led_color_t color = {0};
  if (saturation == 0)
  {
    color.r = value;
    color.g = value;
    color.b = value;
    return color;
  }

  uint8_t region = hue / 43;
  uint8_t remainder = (hue - (region * 43)) * 6;

  uint8_t p = scale8(value, (uint8_t)(255 - saturation));
  uint8_t q = scale8(value, (uint8_t)(255 - scale8(saturation, remainder)));
  uint8_t t = scale8(value, (uint8_t)(255 - scale8(saturation, (uint8_t)(255 - remainder))));

  switch (region)
  {
    case 0:
      color.r = value;
      color.g = t;
      color.b = p;
      break;
    case 1:
      color.r = q;
      color.g = value;
      color.b = p;
      break;
    case 2:
      color.r = p;
      color.g = value;
      color.b = t;
      break;
    case 3:
      color.r = p;
      color.g = q;
      color.b = value;
      break;
    case 4:
      color.r = t;
      color.g = p;
      color.b = value;
      break;
    default:
      color.r = value;
      color.g = p;
      color.b = q;
      break;
  }
  return color;
}

static thermostat_led_color_t sparkle_random_color(void)
{
  uint8_t hue = random_u8();
  uint8_t saturation = random_u8_range(LED_SPARKLE_SAT_MIN, LED_SPARKLE_SAT_MAX);
  thermostat_led_color_t rgb = hsv_to_rgb(hue, saturation, 255);
  rgb.r = scale8_video(rgb.r, LED_SPARKLE_INTENSITY_SCALE);
  rgb.g = scale8_video(rgb.g, LED_SPARKLE_INTENSITY_SCALE);
  rgb.b = scale8_video(rgb.b, LED_SPARKLE_INTENSITY_SCALE);
  return rgb;
}

static void sparkle_reset(void)
{
  memset(&s_leds.sparkle, 0, sizeof(s_leds.sparkle));
}

static void sparkle_fade_pixels(void)
{
  for (int i = 0; i < THERMOSTAT_LED_COUNT; ++i)
  {
    thermostat_led_color_t *pixel = &s_leds.sparkle.pixels[i];
    pixel->r = scale8(pixel->r, (uint8_t)(255 - LED_SPARKLE_FADE_BY));
    pixel->g = scale8(pixel->g, (uint8_t)(255 - LED_SPARKLE_FADE_BY));
    pixel->b = scale8(pixel->b, (uint8_t)(255 - LED_SPARKLE_FADE_BY));
  }
}

static void sparkle_spawn_pixels(void)
{
  if (s_leds.sparkle.stop_requested)
  {
    return;
  }
  for (uint8_t attempt = 0; attempt < LED_SPARKLE_MAX_SPARKLES; ++attempt)
  {
    if (random_u8() > LED_SPARKLE_SPAWN_PROB)
    {
      continue;
    }
    uint16_t pixel_index = random_pixel_index();
    thermostat_led_color_t *pixel = &s_leds.sparkle.pixels[pixel_index];
    thermostat_led_color_t sparkle = sparkle_random_color();
    pixel->r = saturating_add(pixel->r, sparkle.r);
    pixel->g = saturating_add(pixel->g, sparkle.g);
    pixel->b = saturating_add(pixel->b, sparkle.b);
  }
}

static bool sparkle_is_dark(void)
{
  for (int i = 0; i < THERMOSTAT_LED_COUNT; ++i)
  {
    const thermostat_led_color_t *pixel = &s_leds.sparkle.pixels[i];
    if (pixel->r != 0 || pixel->g != 0 || pixel->b != 0)
    {
      return false;
    }
  }
  return true;
}

static void update_sparkle(void)
{
  s_leds.sparkle.tick_accumulator++;
  if (s_leds.sparkle.tick_accumulator < LED_SPARKLE_TICKS_PER_FRAME)
  {
    return;
  }
  s_leds.sparkle.tick_accumulator = 0;

  sparkle_fade_pixels();
  sparkle_spawn_pixels();

  esp_err_t err = write_pixels(s_leds.sparkle.pixels, 1.0f);
  if (err != ESP_OK)
  {
    ESP_LOGW(TAG, "Sparkle refresh failed: %s", esp_err_to_name(err));
    return;
  }

  if (s_leds.sparkle.stop_requested && sparkle_is_dark())
  {
    ESP_LOGD(TAG, "Sparkle drained; stopping animation");
    cancel_current_effect();
  }
}

static void update_rainbow(void)
{
  thermostat_led_color_t pixels[THERMOSTAT_LED_COUNT];
  for (int i = 0; i < THERMOSTAT_LED_COUNT; i++)
  {
    uint8_t hue = s_leds.rainbow.hue_offset + (i * LED_RAINBOW_HUE_DENSITY);
    pixels[i] = hsv_to_rgb(hue, 255, 255);
  }
  s_leds.rainbow.hue_offset += LED_RAINBOW_HUE_SPEED;

  esp_err_t err = write_pixels(pixels, 1.0f);
  if (err != ESP_OK)
  {
    ESP_LOGW(TAG, "Rainbow refresh failed: %s", esp_err_to_name(err));
  }
}

static float wave_pulse_intensity(float normalized_dist)
{
  if (normalized_dist >= 1.0f)
  {
    return 0.0f;
  }
  return (1.0f + cosf(normalized_dist * LED_PI)) * 0.5f;
}

static uint8_t wave_get_pixel_boost(float pixel_pos)
{
  float total_boost = 0.0f;
  for (int w = 0; w < LED_WAVE_COUNT; w++)
  {
    float wave_pos = s_leds.wave.wave_positions[w];
    float dist = fabsf(pixel_pos - wave_pos);
    float norm_dist = dist / LED_WAVE_WIDTH;
    total_boost += wave_pulse_intensity(norm_dist);
  }
  if (total_boost > 1.0f)
  {
    total_boost = 1.0f;
  }
  return (uint8_t)(total_boost * LED_WAVE_PULSE_BRIGHTNESS);
}

static void wave_update_positions(void)
{
  for (int i = 0; i < LED_WAVE_COUNT; i++)
  {
    if (s_leds.wave.rising)
    {
      s_leds.wave.wave_positions[i] += LED_WAVE_SPEED;
      if (s_leds.wave.wave_positions[i] > 1.0f + LED_WAVE_WIDTH)
      {
        s_leds.wave.wave_positions[i] = -LED_WAVE_WIDTH;
      }
    }
    else
    {
      s_leds.wave.wave_positions[i] -= LED_WAVE_SPEED;
      if (s_leds.wave.wave_positions[i] < -LED_WAVE_WIDTH)
      {
        s_leds.wave.wave_positions[i] = 1.0f + LED_WAVE_WIDTH;
      }
    }
  }
}

static void update_wave(void)
{
  thermostat_led_color_t pixels[THERMOSTAT_LED_COUNT];
  thermostat_led_color_t base = s_leds.wave.base_color;

  // Fill with base color
  for (int i = 0; i < THERMOSTAT_LED_COUNT; i++)
  {
    pixels[i] = base;
  }

  // Update wave positions
  wave_update_positions();

  // Render left side: pixels 0-14, position 0 (bottom) to 0.5 (top)
  for (int px = LED_LEFT_START; px <= LED_LEFT_END; px++)
  {
    float pixel_pos = (float)(px - LED_LEFT_START) / (LED_LEFT_END - LED_LEFT_START) * 0.5f;
    uint8_t boost = wave_get_pixel_boost(pixel_pos);
    if (s_leds.wave.rising)
    {
      // Warm tint for heat
      pixels[px].r = saturating_add(pixels[px].r, boost);
      pixels[px].g = saturating_add(pixels[px].g, boost * 5 / 6);
      pixels[px].b = saturating_add(pixels[px].b, boost * 2 / 3);
    }
    else
    {
      // Cool tint for cold
      pixels[px].r = saturating_add(pixels[px].r, boost / 2);
      pixels[px].g = saturating_add(pixels[px].g, boost * 3 / 4);
      pixels[px].b = saturating_add(pixels[px].b, boost);
    }
  }

  // Render right side: pixels 38 (bottom) to 23 (top), position 0 to 0.5
  for (int px = LED_RIGHT_START; px <= LED_RIGHT_END; px++)
  {
    float pixel_pos = (float)(LED_RIGHT_END - px) / (LED_RIGHT_END - LED_RIGHT_START) * 0.5f;
    uint8_t boost = wave_get_pixel_boost(pixel_pos);
    if (s_leds.wave.rising)
    {
      pixels[px].r = saturating_add(pixels[px].r, boost);
      pixels[px].g = saturating_add(pixels[px].g, boost * 5 / 6);
      pixels[px].b = saturating_add(pixels[px].b, boost * 2 / 3);
    }
    else
    {
      pixels[px].r = saturating_add(pixels[px].r, boost / 2);
      pixels[px].g = saturating_add(pixels[px].g, boost * 3 / 4);
      pixels[px].b = saturating_add(pixels[px].b, boost);
    }
  }

  // Render top bar: pixels 15-22, position 0.5 at edges to 1.0 at center
  float top_length = (float)(LED_TOP_END - LED_TOP_START + 1);
  float half_top = top_length / 2.0f;
  for (int px = LED_TOP_START; px <= LED_TOP_END; px++)
  {
    float px_from_left = (float)(px - LED_TOP_START);
    float px_from_right = (float)(LED_TOP_END - px);

    float left_wave_pos = 0.5f + (px_from_left / half_top) * 0.5f;
    float right_wave_pos = 0.5f + (px_from_right / half_top) * 0.5f;

    uint8_t left_boost = wave_get_pixel_boost(left_wave_pos);
    uint8_t right_boost = wave_get_pixel_boost(right_wave_pos);
    uint8_t boost = (left_boost > right_boost) ? left_boost : right_boost;

    if (s_leds.wave.rising)
    {
      pixels[px].r = saturating_add(pixels[px].r, boost);
      pixels[px].g = saturating_add(pixels[px].g, boost * 5 / 6);
      pixels[px].b = saturating_add(pixels[px].b, boost * 2 / 3);
    }
    else
    {
      pixels[px].r = saturating_add(pixels[px].r, boost / 2);
      pixels[px].g = saturating_add(pixels[px].g, boost * 3 / 4);
      pixels[px].b = saturating_add(pixels[px].b, boost);
    }
  }

  esp_err_t err = write_pixels(pixels, 1.0f);
  if (err != ESP_OK)
  {
    ESP_LOGW(TAG, "Wave refresh failed: %s", esp_err_to_name(err));
  }
}

static float greeting_step(void)
{
  float span = (float)(THERMOSTAT_LED_COUNT - LED_GREETING_BAND_WIDTH);
  float steps = (float)LED_GREETING_SWEEP_MS / (float)LED_TIMER_PERIOD_MS;
  if (steps <= 0.0f)
  {
    steps = 1.0f;
  }
  if (span <= 0.0f)
  {
    span = 1.0f;
  }
  return span / steps;
}

static void greeting_reset(void)
{
  memset(&s_leds.greeting, 0, sizeof(s_leds.greeting));
  s_leds.greeting.direction = 1;
  s_leds.greeting.loops_remaining = LED_GREETING_PASSES;
  s_leds.greeting.step = greeting_step();
}

static void greeting_fade_pixels(void)
{
  for (int i = 0; i < THERMOSTAT_LED_COUNT; ++i)
  {
    thermostat_led_color_t *pixel = &s_leds.greeting.pixels[i];
    pixel->r = scale8(pixel->r, (uint8_t)LED_GREETING_TAIL_DECAY);
    pixel->g = scale8(pixel->g, (uint8_t)LED_GREETING_TAIL_DECAY);
    pixel->b = scale8(pixel->b, (uint8_t)LED_GREETING_TAIL_DECAY);
  }
}

static void greeting_paint_band(void)
{
  thermostat_led_color_t band_color = thermostat_led_color(0x8C, 0x50, 0xFF);
  int max_head = THERMOSTAT_LED_COUNT - LED_GREETING_BAND_WIDTH;
  if (max_head < 0)
  {
    max_head = 0;
  }
  int head_index = (int)lroundf(s_leds.greeting.head_index);
  if (head_index < 0)
  {
    head_index = 0;
  }
  if (head_index > max_head)
  {
    head_index = max_head;
  }

  for (int i = 0; i < LED_GREETING_BAND_WIDTH; ++i)
  {
    int pixel_index = head_index + i;
    if (pixel_index >= THERMOSTAT_LED_COUNT)
    {
      break;
    }
    s_leds.greeting.pixels[pixel_index] = band_color;
  }
}

static void update_greeting(void)
{
  greeting_fade_pixels();
  greeting_paint_band();

  esp_err_t err = write_pixels(s_leds.greeting.pixels, LED_GREETING_BRIGHTNESS);
  if (err != ESP_OK)
  {
    ESP_LOGW(TAG, "Greeting refresh failed: %s", esp_err_to_name(err));
  }

  float max_index = (float)(THERMOSTAT_LED_COUNT - LED_GREETING_BAND_WIDTH);
  if (max_index < 0.0f)
  {
    max_index = 0.0f;
  }

  s_leds.greeting.head_index += (float)s_leds.greeting.direction * s_leds.greeting.step;
  bool flipped = false;
  if (s_leds.greeting.head_index >= max_index)
  {
    s_leds.greeting.head_index = max_index;
    s_leds.greeting.direction = -1;
    flipped = true;
  }
  else if (s_leds.greeting.head_index <= 0.0f)
  {
    s_leds.greeting.head_index = 0.0f;
    s_leds.greeting.direction = 1;
    flipped = true;
  }

  if (flipped && s_leds.greeting.loops_remaining > 0)
  {
    s_leds.greeting.loops_remaining--;
  }

  if (s_leds.greeting.loops_remaining == 0)
  {
    cancel_current_effect();
  }
}

static esp_err_t write_fill(thermostat_led_color_t color, float brightness)
{
  if (!s_leds.available)
  {
    return ESP_ERR_INVALID_STATE;
  }

  float requested_brightness = clamp_unit(brightness);
  float applied_brightness = apply_output_brightness_policy(requested_brightness);
  uint32_t r = (uint32_t)lroundf((float)color.r * applied_brightness);
  uint32_t g = (uint32_t)lroundf((float)color.g * applied_brightness);
  uint32_t b = (uint32_t)lroundf((float)color.b * applied_brightness);

  for (int i = 0; i < THERMOSTAT_LED_COUNT; ++i)
  {
    // Strip uses GRB native ordering.
    esp_err_t pixel_err = led_strip_set_pixel(s_leds.strip, i, g, r, b);
    if (pixel_err != ESP_OK)
    {
      return pixel_err;
    }
  }
  esp_err_t err = led_strip_refresh(s_leds.strip);
  if (err == ESP_OK)
  {
    s_leds.latched_color = color;
    s_leds.latched_brightness = requested_brightness;
  }
  else
  {
    ESP_LOGW(TAG, "LED refresh failed (%s)", esp_err_to_name(err));
  }
  return err;
}

static esp_err_t write_pixels(const thermostat_led_color_t *pixels, float brightness)
{
  if (!s_leds.available)
  {
    return ESP_ERR_INVALID_STATE;
  }

  float applied_brightness = apply_output_brightness_policy(brightness);
  for (int i = 0; i < THERMOSTAT_LED_COUNT; ++i)
  {
    uint32_t r = (uint32_t)lroundf((float)pixels[i].r * applied_brightness);
    uint32_t g = (uint32_t)lroundf((float)pixels[i].g * applied_brightness);
    uint32_t b = (uint32_t)lroundf((float)pixels[i].b * applied_brightness);
    esp_err_t pixel_err = led_strip_set_pixel(s_leds.strip, i, g, r, b);
    if (pixel_err != ESP_OK)
    {
      return pixel_err;
    }
  }

  esp_err_t err = led_strip_refresh(s_leds.strip);
  if (err != ESP_OK)
  {
    ESP_LOGW(TAG, "LED refresh failed (%s)", esp_err_to_name(err));
  }
  return err;
}

esp_err_t thermostat_leds_init(void)
{
#if !CONFIG_THEO_LED_ENABLE
  ESP_LOGI(TAG, "LED notifications disabled via CONFIG_THEO_LED_ENABLE");
  s_leds.available = false;
  return ESP_ERR_NOT_SUPPORTED;
#else
  if (s_leds.initialized)
  {
    return ESP_OK;
  }

  // Physical layout: 15 pixels up the left edge (bottom→top), 8 across the top (left→right),
  // then 16 down the right edge (top→bottom).
  led_strip_config_t strip_config = {
      .strip_gpio_num = CONFIG_THEO_LED_STRIP_GPIO,
      .max_leds = THERMOSTAT_LED_COUNT,
      .led_model = LED_MODEL_WS2812,
      //! This may look wrong, but it is absolutely correct. Do not change RGB to GRB, or
      //! you will be breaking the software!
      .color_component_format = LED_STRIP_COLOR_COMPONENT_FMT_RGB,
      .flags = {.invert_out = 0},
  };
  led_strip_rmt_config_t rmt_config = {
      .clk_src = RMT_CLK_SRC_DEFAULT,
      .resolution_hz = 10 * 1000 * 1000,
      .mem_block_symbols = 0,
      .flags = {.with_dma = 0},
  };

  esp_err_t err = led_strip_new_rmt_device(&strip_config, &rmt_config, &s_leds.strip);
  if (err != ESP_OK)
  {
    ESP_LOGE(TAG, "LED strip init failed (%s)", esp_err_to_name(err));
    return err;
  }
  err = led_strip_clear(s_leds.strip);
  if (err != ESP_OK)
  {
    ESP_LOGE(TAG, "Failed to clear strip (%s)", esp_err_to_name(err));
    goto cleanup;
  }
  err = led_strip_refresh(s_leds.strip);
  if (err != ESP_OK)
  {
    ESP_LOGE(TAG, "Failed to refresh strip (%s)", esp_err_to_name(err));
    goto cleanup;
  }

  ensure_timer_created();
  if (!s_leds.timer)
  {
    err = ESP_FAIL;
    goto cleanup;
  }

  s_leds.initialized = true;
  s_leds.available = true;
  s_leds.effect = LED_EFFECT_IDLE;
  s_leds.latched_color = thermostat_led_color(0, 0, 0);
  s_leds.latched_brightness = 0.0f;
  s_leds.quiet_gate_active = false;

  ESP_LOGI(TAG, "LED strip ready on GPIO %d", CONFIG_THEO_LED_STRIP_GPIO);
  return ESP_OK;

cleanup:
  if (s_leds.strip)
  {
    led_strip_del(s_leds.strip);
    s_leds.strip = NULL;
  }
  return err;
#endif
}

bool thermostat_leds_available(void)
{
  return s_leds.available;
}

void thermostat_leds_notify_boot_complete(void)
{
  if (s_leds.available)
  {
    s_leds.quiet_gate_active = true;
    ESP_LOGI(TAG, "Boot stage done; LED quiet-hours dimming now enforced");
  }
}

static esp_err_t start_fade(thermostat_led_color_t color, float start_brightness, float target_brightness, uint32_t fade_ms, led_easing_t easing)
{
  if (!s_leds.available)
  {
    return ESP_ERR_INVALID_STATE;
  }

  if (fade_ms < LED_MIN_FADE_DURATION_MS)
  {
    fade_ms = LED_MIN_FADE_DURATION_MS;
  }

  cancel_current_effect();
  s_leds.effect = LED_EFFECT_FADE;
  s_leds.fade.color = color;
  s_leds.fade.start_brightness = clamp_unit(start_brightness);
  s_leds.fade.target_brightness = clamp_unit(target_brightness);
  s_leds.fade.start_time_us = esp_timer_get_time();
  s_leds.fade.duration_us = (int64_t)fade_ms * 1000;
  s_leds.fade.easing = easing;

  write_fill(color, s_leds.fade.start_brightness);
  start_timer();
  return ESP_OK;
}

esp_err_t thermostat_leds_solid_with_fade(thermostat_led_color_t color, uint32_t fade_ms)
{
  if (!s_leds.available)
  {
    return ESP_ERR_INVALID_STATE;
  }

  char cue[32];
  format_cue_desc(cue, sizeof(cue), "LED fade", color);
  esp_err_t err = guard_output(cue);
  if (err != ESP_OK)
  {
    return err;
  }

  ESP_LOGD(TAG, "LED fade to #%02x%02x%02x over %ums", color.r, color.g, color.b, (unsigned)fade_ms);
  return start_fade(color, 0.0f, 1.0f, fade_ms, LED_EASING_LINEAR);
}

esp_err_t thermostat_leds_solid_with_fade_brightness(thermostat_led_color_t color, uint32_t fade_ms,
                                                     float brightness)
{
  if (!s_leds.available)
  {
    return ESP_ERR_INVALID_STATE;
  }

  char cue[32];
  format_cue_desc(cue, sizeof(cue), "LED fade", color);
  esp_err_t err = guard_output(cue);
  if (err != ESP_OK)
  {
    return err;
  }

  ESP_LOGD(TAG, "LED fade to #%02x%02x%02x @ %.0f%% over %ums", color.r, color.g, color.b,
           brightness * 100.0f, (unsigned)fade_ms);
  return start_fade(color, 0.0f, brightness, fade_ms, LED_EASING_LINEAR);
}

esp_err_t thermostat_leds_off_with_fade(uint32_t fade_ms)
{
  if (!s_leds.available)
  {
    return ESP_ERR_INVALID_STATE;
  }

  ESP_LOGD(TAG, "LED fade to black (ease-in) over %ums", (unsigned)fade_ms);
  return start_fade(s_leds.latched_color, s_leds.latched_brightness, 0.0f, fade_ms, LED_EASING_EASE_IN);
}

esp_err_t thermostat_leds_off_with_fade_eased(uint32_t fade_ms)
{
  if (!s_leds.available)
  {
    return ESP_ERR_INVALID_STATE;
  }

  ESP_LOGD(TAG, "LED fade to black (ease-out) over %ums", (unsigned)fade_ms);
  return start_fade(s_leds.latched_color, s_leds.latched_brightness, 0.0f, fade_ms, LED_EASING_EASE_OUT);
}

esp_err_t thermostat_leds_pulse(thermostat_led_color_t color, float hz)
{
  if (!s_leds.available)
  {
    return ESP_ERR_INVALID_STATE;
  }
  if (hz <= 0.0f)
  {
    return ESP_ERR_INVALID_ARG;
  }

  char cue[32];
  format_cue_desc(cue, sizeof(cue), "LED pulse", color);
  esp_err_t err = guard_output(cue);
  if (err != ESP_OK)
  {
    return err;
  }

  ESP_LOGD(TAG, "LED pulse #%02x%02x%02x @ %.2f Hz", color.r, color.g, color.b, hz);
  cancel_current_effect();
  s_leds.effect = LED_EFFECT_PULSE;
  s_leds.pulse.color = color;
  s_leds.pulse.hz = hz;
  s_leds.pulse.start_time_us = esp_timer_get_time();
  start_timer();
  return ESP_OK;
}

esp_err_t thermostat_leds_start_sparkle(void)
{
  if (!s_leds.available)
  {
    return ESP_ERR_INVALID_STATE;
  }

  esp_err_t err = guard_output("LED sparkle");
  if (err != ESP_OK)
  {
    return err;
  }

  ESP_LOGD(TAG, "LED sparkle start");
  cancel_current_effect();
  sparkle_reset();
  s_leds.effect = LED_EFFECT_SPARKLE;
  start_timer();
  return ESP_OK;
}

esp_err_t thermostat_leds_rainbow(void)
{
  if (!s_leds.available)
  {
    return ESP_ERR_INVALID_STATE;
  }

  esp_err_t err = guard_output("LED rainbow");
  if (err != ESP_OK)
  {
    return err;
  }

  ESP_LOGD(TAG, "LED rainbow start");
  cancel_current_effect();
  s_leds.rainbow.hue_offset = 0;
  s_leds.effect = LED_EFFECT_RAINBOW;
  start_timer();
  return ESP_OK;
}

static void wave_init_positions(void)
{
  float spacing = (1.0f + 2 * LED_WAVE_WIDTH) / LED_WAVE_COUNT;
  for (int i = 0; i < LED_WAVE_COUNT; i++)
  {
    s_leds.wave.wave_positions[i] = -LED_WAVE_WIDTH + i * spacing;
  }
}

esp_err_t thermostat_leds_wave_rising(thermostat_led_color_t color)
{
  if (!s_leds.available)
  {
    return ESP_ERR_INVALID_STATE;
  }

  char cue[32];
  format_cue_desc(cue, sizeof(cue), "LED wave rise", color);
  esp_err_t err = guard_output(cue);
  if (err != ESP_OK)
  {
    return err;
  }

  ESP_LOGD(TAG, "LED wave rising #%02x%02x%02x", color.r, color.g, color.b);
  cancel_current_effect();
  s_leds.wave.base_color = color;
  s_leds.wave.rising = true;
  wave_init_positions();
  s_leds.effect = LED_EFFECT_WAVE;
  start_timer();
  return ESP_OK;
}

esp_err_t thermostat_leds_wave_falling(thermostat_led_color_t color)
{
  if (!s_leds.available)
  {
    return ESP_ERR_INVALID_STATE;
  }

  char cue[32];
  format_cue_desc(cue, sizeof(cue), "LED wave fall", color);
  esp_err_t err = guard_output(cue);
  if (err != ESP_OK)
  {
    return err;
  }

  ESP_LOGD(TAG, "LED wave falling #%02x%02x%02x", color.r, color.g, color.b);
  cancel_current_effect();
  s_leds.wave.base_color = color;
  s_leds.wave.rising = false;
  wave_init_positions();
  s_leds.effect = LED_EFFECT_WAVE;
  start_timer();
  return ESP_OK;
}

esp_err_t thermostat_leds_start_greeting(void)
{
  if (!s_leds.available)
  {
    return ESP_ERR_INVALID_STATE;
  }

  ESP_LOGD(TAG, "LED greeting triggered");
  cancel_current_effect();
  greeting_reset();
  s_leds.effect = LED_EFFECT_GREETING;
  start_timer();
  return ESP_OK;
}

void thermostat_leds_stop_animation(void)
{
  if (!s_leds.available)
  {
    return;
  }
  if (s_leds.effect == LED_EFFECT_SPARKLE)
  {
    if (!s_leds.sparkle.stop_requested)
    {
      s_leds.sparkle.stop_requested = true;
      ESP_LOGD(TAG, "Sparkle drain requested");
    }
    return;
  }
  cancel_current_effect();
}

bool thermostat_leds_is_animating(void)
{
  return s_leds.available && s_leds.effect != LED_EFFECT_IDLE;
}

static void complete_fade_if_done(int64_t now)
{
  if (s_leds.effect != LED_EFFECT_FADE)
  {
    return;
  }

  int64_t elapsed = now - s_leds.fade.start_time_us;
  if (elapsed < 0)
  {
    elapsed = 0;
  }

  float progress = (float)elapsed / (float)s_leds.fade.duration_us;
  if (progress > 1.0f)
  {
    progress = 1.0f;
  }

  float eased_progress = apply_easing(progress, s_leds.fade.easing);
  float brightness = s_leds.fade.start_brightness + (s_leds.fade.target_brightness - s_leds.fade.start_brightness) * eased_progress;
  write_fill(s_leds.fade.color, brightness);

  if (progress >= 1.0f)
  {
    if (s_leds.fade.target_brightness == 0.0f)
    {
      s_leds.latched_color = thermostat_led_color(0, 0, 0);
    }
    cancel_current_effect();
  }
}

static void update_pulse(int64_t now)
{
  if (s_leds.effect != LED_EFFECT_PULSE)
  {
    return;
  }

  float elapsed_s = (float)(now - s_leds.pulse.start_time_us) / 1000000.0f;
  if (elapsed_s < 0.0f)
  {
    elapsed_s = 0.0f;
  }

  float period = 1.0f / s_leds.pulse.hz;
  if (period <= 0.0f)
  {
    period = 1.0f;
  }

  float phase = fmodf(elapsed_s, period) / period;
  float brightness = 0.5f - 0.5f * cosf(phase * 2.0f * LED_PI);
  write_fill(s_leds.pulse.color, brightness);
}

static void led_effect_timer(void *arg)
{
  int64_t now = esp_timer_get_time();
  if (s_leds.effect == LED_EFFECT_FADE)
  {
    complete_fade_if_done(now);
  }
  else if (s_leds.effect == LED_EFFECT_PULSE)
  {
    update_pulse(now);
  }
  else if (s_leds.effect == LED_EFFECT_SPARKLE)
  {
    update_sparkle();
  }
  else if (s_leds.effect == LED_EFFECT_RAINBOW)
  {
    update_rainbow();
  }
  else if (s_leds.effect == LED_EFFECT_WAVE)
  {
    update_wave();
  }

  if (s_leds.effect == LED_EFFECT_IDLE)
  {
    stop_timer();
  }
}
