shyndman/esp-theoretical-thermostat/main/thermostat/application_cues.h

#pragma once

#include <stdbool.h>
#include <stddef.h>

#include "esp_err.h"

/**
 * Shared gate for application cues (audio, LEDs, etc.).
 * Returns ESP_OK when the cue may play, ESP_ERR_NOT_SUPPORTED when the build flag
 * disables the feature, and ESP_ERR_INVALID_STATE when quiet hours or clock
 * readiness block output.
 */
esp_err_t thermostat_application_cues_check(const char *cue_name, bool feature_enabled);

/**
 * Returns whether quiet hours are currently active.
 * Returns ESP_OK and writes false when quiet hours are disabled, or true/false once
 * the local clock is synchronized. Returns ESP_ERR_INVALID_STATE while quiet hours
 * are configured but SNTP has not synchronized yet.
 */
esp_err_t thermostat_application_cues_quiet_hours_active(bool *active);

/**
 * Format helper for documentation/logs.
 * Returns true when quiet hours are configured and writes "HH:MM-HH:MM" into
 * the provided buffer (including null terminator) when possible.
 */
bool thermostat_application_cues_window_string(char *buffer, size_t buffer_len);
