shyndman/esp-theoretical-thermostat/main/thermostat/ui_splash.c

#include "thermostat/ui_splash.h"

#include <stdbool.h>
#include <stdio.h>
#include <stdlib.h>
#include <string.h>

#include "assets/fonts/thermostat_fonts.h"
#include "esp_check.h"
#include "esp_log.h"
#include "esp_lv_adapter.h"
#include "thermostat/ui_animation_timing.h"
#include "thermostat/ui_entrance_anim.h"

#define SPLASH_TEXT_MAX 128
#define SPLASH_HISTORY_COUNT 8
#define SPLASH_PENDING_CAPACITY 16
#define SPLASH_ROW_HEIGHT_PX 48
#define SPLASH_ROW_SPACING_PX 6
#define SPLASH_ROW_ADVANCE_PX (SPLASH_ROW_HEIGHT_PX + SPLASH_ROW_SPACING_PX)
#define SPLASH_SLIDE_DURATION_MS THERMOSTAT_ANIM_SPLASH_LINE_SLIDE_MS
#define SPLASH_FADE_OUT_DURATION 150
#define SPLASH_FADE_IN_DURATION THERMOSTAT_ANIM_SPLASH_LINE_FADE_IN_MS
#define SPLASH_STACK_OFFSET_Y (-50)
#define SPLASH_STACK_PAD_LEFT 20
#define SPLASH_DEMOTE_OPACITY ((lv_opa_t)((LV_OPA_COVER * 65) / 100))
#define SPLASH_WHITE_COLOR_HEX 0xffffff

typedef struct splash_line
{
  char text[SPLASH_TEXT_MAX];
  lv_color_t color;
  bool valid;
  bool faded;
} splash_line_t;

typedef struct splash_anim_ref
{
  struct thermostat_splash *splash;
  uint8_t row_index;
} splash_anim_ref_t;

typedef struct splash_color_anim_ref
{
  struct thermostat_splash *splash;
  lv_color_t from;
  lv_color_t to;
} splash_color_anim_ref_t;

struct thermostat_splash
{
  lv_obj_t *screen;
  lv_obj_t *stack;
  lv_obj_t *rows[SPLASH_HISTORY_COUNT];
  splash_anim_ref_t anim_refs[SPLASH_HISTORY_COUNT];
  splash_color_anim_ref_t screen_fade;
  splash_line_t history[SPLASH_HISTORY_COUNT];
  splash_line_t pending[SPLASH_PENDING_CAPACITY];
  size_t pending_head;
  size_t pending_tail;
  size_t pending_count;
  uint8_t active_rows;
  bool animating;
  bool destroy_requested;
  bool screen_fading;
  bool exit_signal_received;
  bool exit_prepared;
  bool status_locked;
  bool status_updates_blocked;
  bool keep_head_visible;
  bool line_fade_started;
  bool white_fade_started;
  thermostat_splash_destroy_cb_t destroy_cb;
  void *destroy_cb_ctx;
  lv_obj_t *pending_screen;
  lv_color_t status_color;
  lv_color_t error_color;
  char last_status_text[SPLASH_TEXT_MAX];
  lv_color_t last_status_color;
  bool last_status_valid;
};

static const char *TAG = "ui_splash";
static thermostat_splash_t *s_active_splash = NULL;
static lv_timer_t *s_entrance_timer = NULL;

static esp_err_t lock_lvgl(void);
static void unlock_lvgl(void);
static void format_stage_error(const char *stage_name, esp_err_t err, char *out, size_t out_size);
static lv_color_t splash_mix_color(lv_color_t from, lv_color_t to, uint8_t mix);
static esp_err_t splash_enqueue(thermostat_splash_t *splash, const char *text, lv_color_t color);
static bool splash_pop_pending(thermostat_splash_t *splash, splash_line_t *out);
static void splash_rotate_history(thermostat_splash_t *splash, const splash_line_t *next_line);
static void splash_apply_history_to_rows(thermostat_splash_t *splash, bool hide_head);
static void splash_start_animation_if_idle(thermostat_splash_t *splash);
static void splash_launch_animations(thermostat_splash_t *splash, bool fade_demoted);
static void splash_handle_translate_complete(thermostat_splash_t *splash);
static void splash_start_fade_in_locked(thermostat_splash_t *splash);
static void splash_translate_exec_cb(void *var, int32_t value);
static void splash_opacity_exec_cb(void *var, int32_t value);
static void splash_row_opacity_exec_cb(void *var, int32_t value);
static void splash_screen_color_exec_cb(void *var, int32_t value);
static void splash_translate_ready_cb(lv_anim_t *anim);
static void splash_fade_in_ready_cb(lv_anim_t *anim);
static void splash_white_fade_ready_cb(lv_anim_t *anim);
static void splash_flush_pending_queue(thermostat_splash_t *splash);
static void splash_lock_status_updates(thermostat_splash_t *splash);
static void splash_begin_line_fade(thermostat_splash_t *splash);
static void splash_begin_line_fade_locked(thermostat_splash_t *splash);
static void splash_begin_white_fade_locked(thermostat_splash_t *splash);
static void splash_cancel_row_anims_locked(thermostat_splash_t *splash);
static void splash_prepare_exit(thermostat_splash_t *splash);
static void splash_begin_exit_if_ready(thermostat_splash_t *splash);
static void splash_start_exit_sequence(thermostat_splash_t *splash);
static void splash_schedule_entrance_start(void);
static void splash_entrance_timer_cb(lv_timer_t *timer);
static void splash_retry_exit_cb(lv_timer_t *timer);
static bool splash_color_equal(lv_color_t a, lv_color_t b);

#define SPLASH_EXIT_RETRY_DELAY_MS (200)
#define SPLASH_EXIT_RETRY_WARN_EVERY (5)

static esp_err_t lock_lvgl(void)
{
  if (esp_lv_adapter_lock(-1) != ESP_OK)
  {
    return ESP_FAIL;
  }
  return ESP_OK;
}

static void unlock_lvgl(void)
{
  esp_lv_adapter_unlock();
}

static void format_stage_error(const char *stage_name, esp_err_t err, char *out, size_t out_size)
{
  (void)err;
  snprintf(out, out_size, "Failed to %s", stage_name);
}

static lv_color_t splash_mix_color(lv_color_t from, lv_color_t to, uint8_t mix)
{
  uint8_t inv = 255 - mix;
  uint8_t r = (uint8_t)((from.red * inv + to.red * mix) / 255);
  uint8_t g = (uint8_t)((from.green * inv + to.green * mix) / 255);
  uint8_t b = (uint8_t)((from.blue * inv + to.blue * mix) / 255);
  return lv_color_make(r, g, b);
}

thermostat_splash_t *thermostat_splash_create(lv_display_t *disp)
{
  if (!disp)
  {
    return NULL;
  }

  if (lock_lvgl() != ESP_OK)
  {
    return NULL;
  }

  thermostat_splash_t *ctx = calloc(1, sizeof(thermostat_splash_t));
  if (!ctx)
  {
    unlock_lvgl();
    return NULL;
  }

  ctx->status_color = lv_color_hex(0xe4edf2);
  ctx->error_color = lv_color_hex(0xff6666);
  ctx->last_status_valid = false;

  lv_obj_t *screen = lv_obj_create(NULL);
  lv_obj_remove_style_all(screen);
  lv_obj_clear_flag(screen, LV_OBJ_FLAG_SCROLLABLE);
  lv_obj_set_style_bg_color(screen, lv_color_hex(0x101418), LV_PART_MAIN);
  lv_obj_set_style_bg_opa(screen, LV_OPA_COVER, LV_PART_MAIN);

  lv_obj_t *stack = lv_obj_create(screen);
  lv_obj_remove_style_all(stack);
  lv_obj_set_style_bg_opa(stack, LV_OPA_TRANSP, LV_PART_MAIN);
  lv_obj_set_flex_flow(stack, LV_FLEX_FLOW_COLUMN);
  lv_obj_set_style_pad_left(stack, SPLASH_STACK_PAD_LEFT, LV_PART_MAIN);
  lv_obj_set_style_pad_row(stack, SPLASH_ROW_SPACING_PX, LV_PART_MAIN);
  lv_obj_set_style_pad_top(stack, 0, LV_PART_MAIN);
  lv_obj_set_style_pad_bottom(stack, 0, LV_PART_MAIN);
  lv_obj_set_width(stack, lv_pct(90));
  lv_coord_t stack_height = (SPLASH_ROW_HEIGHT_PX * SPLASH_HISTORY_COUNT) +
                            (SPLASH_ROW_SPACING_PX * (SPLASH_HISTORY_COUNT - 1));
  lv_obj_set_height(stack, stack_height);
  lv_obj_clear_flag(stack, LV_OBJ_FLAG_SCROLLABLE);
  lv_obj_align(stack, LV_ALIGN_CENTER, 0, SPLASH_STACK_OFFSET_Y);

  ctx->screen = screen;
  ctx->stack = stack;

  for (uint8_t i = 0; i < SPLASH_HISTORY_COUNT; ++i)
  {
    lv_obj_t *row = lv_label_create(stack);
    lv_obj_set_width(row, lv_pct(100));
    lv_obj_set_height(row, SPLASH_ROW_HEIGHT_PX);
    lv_label_set_long_mode(row, LV_LABEL_LONG_CLIP);
    lv_obj_set_style_text_font(row, THERMOSTAT_FONT_SPLASH, LV_PART_MAIN);
    lv_obj_set_style_text_color(row, ctx->status_color, LV_PART_MAIN);
    lv_obj_set_style_opa(row, LV_OPA_TRANSP, LV_PART_MAIN);
    lv_label_set_text(row, "");
    ctx->rows[i] = row;
    ctx->anim_refs[i].splash = ctx;
    ctx->anim_refs[i].row_index = i;
  }

  splash_line_t initial = {0};
  snprintf(initial.text, sizeof(initial.text), "System running…");
  initial.color = ctx->status_color;
  initial.valid = true;
  initial.faded = false;
  ctx->history[0] = initial;
  ctx->active_rows = 1;
  splash_apply_history_to_rows(ctx, false);

  lv_scr_load(screen);

  unlock_lvgl();
  s_active_splash = ctx;
  return ctx;
}

void thermostat_splash_destroy(thermostat_splash_t *splash,
                               thermostat_splash_destroy_cb_t on_destroy,
                               void *user_ctx)
{
  if (!splash)
  {
    return;
  }

  if (splash->destroy_requested)
  {
    return;
  }

  splash->destroy_requested = true;
  splash->destroy_cb = on_destroy;
  splash->destroy_cb_ctx = user_ctx;
  splash_lock_status_updates(splash);
  splash_begin_line_fade(splash);
  splash_prepare_exit(splash);

  if (!splash->animating)
  {
    splash_begin_exit_if_ready(splash);
  }
}

void thermostat_splash_begin_white_fade(void)
{
  thermostat_splash_t *splash = s_active_splash;
  if (!splash || splash->white_fade_started)
  {
    return;
  }

  if (lock_lvgl() != ESP_OK)
  {
    ESP_LOGW(TAG, "splash_begin_white_fade: LVGL lock failed; skipping");
    return;
  }

  splash_begin_white_fade_locked(splash);
  unlock_lvgl();
}

void thermostat_splash_begin_fade(void)
{
  thermostat_splash_t *splash = s_active_splash;
  if (!splash)
  {
    return;
  }

  splash->exit_signal_received = true;
  splash_begin_exit_if_ready(splash);
}

esp_err_t thermostat_splash_set_status(thermostat_splash_t *splash, const char *status_text)
{
  if (!status_text)
  {
    return ESP_ERR_INVALID_ARG;
  }

  if (!splash)
  {
    return ESP_ERR_INVALID_ARG;
  }
  if (splash->status_locked)
  {
    return ESP_OK;
  }
  if (splash->status_updates_blocked)
  {
    return ESP_OK;
  }

  if (splash && splash->last_status_valid &&
      strcmp(splash->last_status_text, status_text) == 0 &&
      splash_color_equal(splash->last_status_color, splash->status_color))
  {
    return ESP_OK;
  }

  ESP_RETURN_ON_ERROR(splash_enqueue(splash, status_text, splash->status_color),
                      TAG,
                      "enqueue status failed");
  if (splash)
  {
    snprintf(splash->last_status_text, sizeof(splash->last_status_text), "%s", status_text);
    splash->last_status_color = splash->status_color;
    splash->last_status_valid = true;
  }
  splash_start_animation_if_idle(splash);
  return ESP_OK;
}

esp_err_t thermostat_splash_set_status_color(thermostat_splash_t *splash,
                                             const char *status_text,
                                             lv_color_t color)
{
  if (!status_text)
  {
    return ESP_ERR_INVALID_ARG;
  }

  if (!splash)
  {
    return ESP_ERR_INVALID_ARG;
  }
  if (splash->status_locked)
  {
    return ESP_OK;
  }
  if (splash->status_updates_blocked)
  {
    return ESP_OK;
  }

  if (splash && splash->last_status_valid &&
      strcmp(splash->last_status_text, status_text) == 0 &&
      splash_color_equal(splash->last_status_color, color))
  {
    return ESP_OK;
  }

  ESP_RETURN_ON_ERROR(splash_enqueue(splash, status_text, color),
                      TAG,
                      "enqueue status failed");
  if (splash)
  {
    snprintf(splash->last_status_text, sizeof(splash->last_status_text), "%s", status_text);
    splash->last_status_color = color;
    splash->last_status_valid = true;
  }
  splash_start_animation_if_idle(splash);
  return ESP_OK;
}

esp_err_t thermostat_splash_show_error(thermostat_splash_t *splash, const char *stage_name, esp_err_t err)
{
  if (!stage_name)
  {
    return ESP_ERR_INVALID_ARG;
  }

  if (!splash)
  {
    return ESP_ERR_INVALID_ARG;
  }
  if (splash->status_locked)
  {
    return ESP_OK;
  }
  if (splash->status_updates_blocked)
  {
    return ESP_OK;
  }

  char message[SPLASH_TEXT_MAX];
  format_stage_error(stage_name, err, message, sizeof(message));
  ESP_RETURN_ON_ERROR(splash_enqueue(splash, message, splash->error_color),
                      TAG,
                      "enqueue error failed");
  splash_start_animation_if_idle(splash);
  return ESP_OK;
}

esp_err_t thermostat_splash_finalize_status(thermostat_splash_t *splash,
                                            const char *status_text,
                                            lv_color_t color)
{
  if (!status_text)
  {
    return ESP_ERR_INVALID_ARG;
  }

  if (!splash)
  {
    return ESP_ERR_INVALID_ARG;
  }

  if (splash->status_locked)
  {
    return ESP_OK;
  }

  splash->status_updates_blocked = true;
  splash->keep_head_visible = true;
  splash_flush_pending_queue(splash);

  ESP_RETURN_ON_ERROR(splash_enqueue(splash, status_text, color),
                      TAG,
                      "enqueue final status failed");
  splash_start_animation_if_idle(splash);
  return ESP_OK;
}

bool thermostat_splash_is_animating(thermostat_splash_t *splash)
{
  return splash && splash->animating;
}

static esp_err_t splash_enqueue(thermostat_splash_t *splash, const char *text, lv_color_t color)
{
  if (!splash || !text)
  {
    return ESP_ERR_INVALID_ARG;
  }

  if (splash->destroy_requested)
  {
    return ESP_ERR_INVALID_STATE;
  }

  splash_line_t line = {0};
  snprintf(line.text, sizeof(line.text), "%s", text);
  line.color = color;
  line.valid = true;
  line.faded = false;

  if (splash->pending_count == SPLASH_PENDING_CAPACITY)
  {
    splash_line_t *drop = &splash->pending[splash->pending_head];
    ESP_LOGW(TAG, "Splash queue full; dropping \"%s\"", drop->text);
    splash->pending_head = (splash->pending_head + 1) % SPLASH_PENDING_CAPACITY;
    splash->pending_count--;
  }

  splash->pending[splash->pending_tail] = line;
  splash->pending_tail = (splash->pending_tail + 1) % SPLASH_PENDING_CAPACITY;
  splash->pending_count++;
  return ESP_OK;
}

static bool splash_pop_pending(thermostat_splash_t *splash, splash_line_t *out)
{
  if (!splash || !out || splash->pending_count == 0)
  {
    return false;
  }

  *out = splash->pending[splash->pending_head];
  splash->pending_head = (splash->pending_head + 1) % SPLASH_PENDING_CAPACITY;
  splash->pending_count--;
  return true;
}

static void splash_rotate_history(thermostat_splash_t *splash, const splash_line_t *next_line)
{
  if (!splash || !next_line)
  {
    return;
  }

  size_t limit = (splash->active_rows >= SPLASH_HISTORY_COUNT)
                     ? SPLASH_HISTORY_COUNT - 1
                     : splash->active_rows;

  for (size_t i = limit; i > 0; --i)
  {
    splash->history[i] = splash->history[i - 1];
    if (splash->history[i].valid)
    {
      splash->history[i].faded = true;
    }
  }

  splash->history[0] = *next_line;
  splash->history[0].valid = true;
  splash->history[0].faded = false;

  if (splash->active_rows < SPLASH_HISTORY_COUNT)
  {
    splash->active_rows++;
  }

  for (size_t i = splash->active_rows; i < SPLASH_HISTORY_COUNT; ++i)
  {
    splash->history[i].valid = false;
    splash->history[i].faded = false;
    splash->history[i].text[0] = '\0';
  }
}

static void splash_apply_history_to_rows(thermostat_splash_t *splash, bool hide_head)
{
  if (!splash)
  {
    return;
  }

  for (uint8_t i = 0; i < SPLASH_HISTORY_COUNT; ++i)
  {
    lv_obj_t *row = splash->rows[i];
    if (!row)
    {
      continue;
    }

    splash_line_t *line = &splash->history[i];
    if (!line->valid)
    {
      lv_label_set_text(row, "");
      lv_obj_set_style_opa(row, LV_OPA_TRANSP, LV_PART_MAIN);
      continue;
    }

    lv_label_set_text(row, line->text);
    lv_obj_set_style_text_color(row, line->color, LV_PART_MAIN);

    if (i == 0 && hide_head)
    {
      lv_obj_set_style_opa(row, LV_OPA_TRANSP, LV_PART_MAIN);
    }
    else
    {
      lv_obj_set_style_opa(row, line->faded ? SPLASH_DEMOTE_OPACITY : LV_OPA_COVER, LV_PART_MAIN);
    }
  }
}

static void splash_start_animation_if_idle(thermostat_splash_t *splash)
{
  if (!splash || splash->animating)
  {
    return;
  }

  if (splash->status_locked)
  {
    return;
  }

  if (splash->destroy_requested)
  {
    splash_begin_exit_if_ready(splash);
    return;
  }

  splash_line_t next_line = {0};
  if (!splash_pop_pending(splash, &next_line))
  {
    return;
  }

  bool fade_demoted = splash->active_rows > 0 &&
                      splash->history[0].valid &&
                      !splash->history[0].faded;

  splash_rotate_history(splash, &next_line);
  splash->animating = true;
  splash_launch_animations(splash, fade_demoted);
}

static void splash_launch_animations(thermostat_splash_t *splash, bool fade_demoted)
{
  if (!splash)
  {
    return;
  }

  const uint8_t visible_rows = splash->active_rows;
  if (visible_rows == 0)
  {
    if (lock_lvgl() == ESP_OK)
    {
      splash_apply_history_to_rows(splash, false);
      unlock_lvgl();
    }
    splash->animating = false;
    splash_start_animation_if_idle(splash);
    return;
  }

  if (lock_lvgl() != ESP_OK)
  {
    splash->animating = false;
    return;
  }

  for (uint8_t i = 0; i < visible_rows; ++i)
  {
    lv_anim_t anim;
    lv_anim_init(&anim);
    lv_anim_set_var(&anim, &splash->anim_refs[i]);
    lv_anim_set_user_data(&anim, &splash->anim_refs[i]);
    lv_anim_set_exec_cb(&anim, splash_translate_exec_cb);
    lv_anim_set_values(&anim, 0, SPLASH_ROW_ADVANCE_PX);
    lv_anim_set_time(&anim, SPLASH_SLIDE_DURATION_MS);
    lv_anim_set_path_cb(&anim, lv_anim_path_ease_in_out);
    if (i == 0)
    {
      lv_anim_set_ready_cb(&anim, splash_translate_ready_cb);
    }
    lv_anim_start(&anim);
  }

  if (fade_demoted)
  {
    lv_anim_t fade;
    lv_anim_init(&fade);
    lv_anim_set_var(&fade, &splash->anim_refs[0]);
    lv_anim_set_user_data(&fade, &splash->anim_refs[0]);
    lv_anim_set_exec_cb(&fade, splash_opacity_exec_cb);
    lv_anim_set_values(&fade, LV_OPA_COVER, SPLASH_DEMOTE_OPACITY);
    lv_anim_set_time(&fade, SPLASH_FADE_OUT_DURATION);
    lv_anim_set_path_cb(&fade, lv_anim_path_ease_out);
    lv_anim_start(&fade);
  }

  unlock_lvgl();
}

static void splash_handle_translate_complete(thermostat_splash_t *splash)
{
  if (!splash)
  {
    return;
  }

  if (lock_lvgl() != ESP_OK)
  {
    splash->animating = false;
    return;
  }

  for (uint8_t i = 0; i < SPLASH_HISTORY_COUNT; ++i)
  {
    lv_obj_t *row = splash->rows[i];
    if (row)
    {
      lv_obj_set_style_translate_y(row, 0, LV_PART_MAIN);
    }
  }

  splash_apply_history_to_rows(splash, true);
  splash_start_fade_in_locked(splash);
  unlock_lvgl();
}

static void splash_start_fade_in_locked(thermostat_splash_t *splash)
{
  if (!splash || !splash->rows[0])
  {
    splash->animating = false;
    splash_start_animation_if_idle(splash);
    return;
  }

  lv_anim_t anim;
  lv_anim_init(&anim);
  lv_anim_set_var(&anim, &splash->anim_refs[0]);
  lv_anim_set_user_data(&anim, &splash->anim_refs[0]);
  lv_anim_set_exec_cb(&anim, splash_opacity_exec_cb);
  lv_anim_set_values(&anim, LV_OPA_TRANSP, LV_OPA_COVER);
  lv_anim_set_time(&anim, SPLASH_FADE_IN_DURATION);
  lv_anim_set_path_cb(&anim, lv_anim_path_ease_out);
  lv_anim_set_ready_cb(&anim, splash_fade_in_ready_cb);
  lv_anim_start(&anim);
}

static void splash_translate_exec_cb(void *var, int32_t value)
{
  splash_anim_ref_t *ref = (splash_anim_ref_t *)var;
  if (!ref || !ref->splash)
  {
    return;
  }

  lv_obj_t *row = ref->splash->rows[ref->row_index];
  if (row)
  {
    lv_obj_set_style_translate_y(row, value, LV_PART_MAIN);
  }
}

static void splash_opacity_exec_cb(void *var, int32_t value)
{
  splash_anim_ref_t *ref = (splash_anim_ref_t *)var;
  if (!ref || !ref->splash)
  {
    return;
  }

  lv_obj_t *row = ref->splash->rows[ref->row_index];
  if (row)
  {
    lv_obj_set_style_opa(row, (lv_opa_t)value, LV_PART_MAIN);
  }
}

static void splash_row_opacity_exec_cb(void *var, int32_t value)
{
  lv_obj_t *row = (lv_obj_t *)var;
  if (row)
  {
    lv_obj_set_style_opa(row, (lv_opa_t)value, LV_PART_MAIN);
  }
}

static void splash_screen_color_exec_cb(void *var, int32_t value)
{
  splash_color_anim_ref_t *ref = (splash_color_anim_ref_t *)var;
  if (!ref || !ref->splash || !ref->splash->screen)
  {
    return;
  }

  lv_color_t mixed = splash_mix_color(ref->from, ref->to, (uint8_t)value);
  lv_obj_set_style_bg_color(ref->splash->screen, mixed, LV_PART_MAIN);
}

static void splash_translate_ready_cb(lv_anim_t *anim)
{
  splash_anim_ref_t *ref = (splash_anim_ref_t *)lv_anim_get_user_data(anim);
  if (!ref)
  {
    return;
  }

  splash_handle_translate_complete(ref->splash);
}

static void splash_fade_in_ready_cb(lv_anim_t *anim)
{
  splash_anim_ref_t *ref = (splash_anim_ref_t *)lv_anim_get_user_data(anim);
  if (!ref || !ref->splash)
  {
    return;
  }

  thermostat_splash_t *splash = ref->splash;
  splash->animating = false;
  if (splash->destroy_requested)
  {
    splash_begin_exit_if_ready(splash);
    return;
  }
  splash_start_animation_if_idle(splash);
}

static void splash_white_fade_ready_cb(lv_anim_t *anim)
{
  splash_color_anim_ref_t *ref = (splash_color_anim_ref_t *)lv_anim_get_user_data(anim);
  if (!ref || !ref->splash)
  {
    return;
  }

  thermostat_splash_t *splash = ref->splash;
  if (!splash->keep_head_visible || !splash->rows[0])
  {
    splash->keep_head_visible = false;
    return;
  }

  lv_obj_set_style_opa(splash->rows[0], LV_OPA_TRANSP, LV_PART_MAIN);
  splash->keep_head_visible = false;
}

static void splash_flush_pending_queue(thermostat_splash_t *splash)
{
  if (!splash)
  {
    return;
  }

  splash->pending_head = 0;
  splash->pending_tail = 0;
  splash->pending_count = 0;
}

static void splash_lock_status_updates(thermostat_splash_t *splash)
{
  if (!splash)
  {
    return;
  }

  splash->status_locked = true;
  splash->status_updates_blocked = true;
  splash_flush_pending_queue(splash);
}

static void splash_cancel_row_anims_locked(thermostat_splash_t *splash)
{
  if (!splash)
  {
    return;
  }

  splash->animating = false;

  for (uint8_t i = 0; i < SPLASH_HISTORY_COUNT; ++i)
  {
    if (splash->rows[i])
    {
      lv_anim_del(splash->rows[i], NULL);
      lv_obj_set_style_translate_y(splash->rows[i], 0, LV_PART_MAIN);
    }
    lv_anim_del(&splash->anim_refs[i], NULL);
  }
}

static void splash_begin_line_fade(thermostat_splash_t *splash)
{
  if (!splash || splash->line_fade_started)
  {
    return;
  }

  if (lock_lvgl() != ESP_OK)
  {
    ESP_LOGW(TAG, "splash_begin_line_fade: LVGL lock failed; skipping");
    return;
  }

  splash_begin_line_fade_locked(splash);
  unlock_lvgl();
}

static void splash_begin_line_fade_locked(thermostat_splash_t *splash)
{
  if (!splash || splash->line_fade_started)
  {
    return;
  }

  splash->line_fade_started = true;
  splash_cancel_row_anims_locked(splash);

  for (uint8_t i = 0; i < SPLASH_HISTORY_COUNT; ++i)
  {
    lv_obj_t *row = splash->rows[i];
    if (!row || !splash->history[i].valid)
    {
      continue;
    }

    if (i == 0 && splash->keep_head_visible)
    {
      lv_obj_set_style_opa(row, LV_OPA_COVER, LV_PART_MAIN);
      continue;
    }

    lv_anim_t anim;
    lv_anim_init(&anim);
    lv_anim_set_var(&anim, row);
    lv_anim_set_exec_cb(&anim, splash_row_opacity_exec_cb);
    lv_anim_set_values(&anim,
                       lv_obj_get_style_opa(row, LV_PART_MAIN),
                       LV_OPA_TRANSP);
    lv_anim_set_time(&anim, THERMOSTAT_ANIM_SPLASH_LINE_FADE_MS);
    lv_anim_set_delay(&anim, (uint32_t)i * THERMOSTAT_ANIM_SPLASH_LINE_STAGGER_MS);
    lv_anim_set_path_cb(&anim, lv_anim_path_ease_in);
    lv_anim_start(&anim);
  }
}

static void splash_begin_white_fade_locked(thermostat_splash_t *splash)
{
  if (!splash || splash->white_fade_started || !splash->screen)
  {
    return;
  }

  splash->white_fade_started = true;
  splash->screen_fade.splash = splash;
  splash->screen_fade.from = lv_obj_get_style_bg_color(splash->screen, LV_PART_MAIN);
  splash->screen_fade.to = lv_color_hex(SPLASH_WHITE_COLOR_HEX);

  lv_anim_t anim;
  lv_anim_init(&anim);
  lv_anim_set_var(&anim, &splash->screen_fade);
  lv_anim_set_user_data(&anim, &splash->screen_fade);
  lv_anim_set_exec_cb(&anim, splash_screen_color_exec_cb);
  lv_anim_set_values(&anim, 0, 255);
  lv_anim_set_time(&anim, THERMOSTAT_ANIM_LED_WHITE_FADE_IN_MS);
  lv_anim_set_path_cb(&anim, lv_anim_path_ease_in);
  lv_anim_set_ready_cb(&anim, splash_white_fade_ready_cb);
  lv_anim_start(&anim);
}

static void splash_prepare_exit(thermostat_splash_t *splash)
{
  if (!splash || splash->exit_prepared)
  {
    return;
  }

  splash->exit_prepared = true;

  if (lock_lvgl() != ESP_OK)
  {
    ESP_LOGW(TAG, "splash_prepare_exit: LVGL lock failed; will retry");
    splash->exit_prepared = false;
    splash->screen_fading = false;
    if (splash->screen)
    {
      lv_timer_create(splash_retry_exit_cb, SPLASH_EXIT_RETRY_DELAY_MS, splash);
    }
    return;
  }

  if (!splash->line_fade_started)
  {
    splash_begin_line_fade_locked(splash);
  }

  // Extract callback before we transition screens.
  thermostat_splash_destroy_cb_t cb = splash->destroy_cb;
  void *cb_ctx = splash->destroy_cb_ctx;
  splash->destroy_cb = NULL;
  splash->destroy_cb_ctx = NULL;

  // Call the callback WITHOUT the lock to create and load the new screen.
  if (cb)
  {
    cb(cb_ctx);
  }

  splash->pending_screen = lv_scr_act();
  if (splash->screen)
  {
    lv_scr_load(splash->screen);
  }

  unlock_lvgl();
}

static void splash_begin_exit_if_ready(thermostat_splash_t *splash)
{
  if (!splash || splash->screen_fading)
  {
    return;
  }

  if (!splash->destroy_requested || !splash->exit_signal_received)
  {
    return;
  }

  if (!splash->exit_prepared)
  {
    splash_prepare_exit(splash);
  }

  splash_start_exit_sequence(splash);
}

static void splash_schedule_entrance_start(void)
{
  if (s_entrance_timer)
  {
    lv_timer_del(s_entrance_timer);
    s_entrance_timer = NULL;
  }

  if (THERMOSTAT_ANIM_ENTRANCE_START_DELAY_MS <= 0)
  {
    thermostat_entrance_anim_start();
    return;
  }

  s_entrance_timer = lv_timer_create(splash_entrance_timer_cb,
                                     THERMOSTAT_ANIM_ENTRANCE_START_DELAY_MS,
                                     NULL);
  if (s_entrance_timer)
  {
    lv_timer_set_repeat_count(s_entrance_timer, 1);
  }
}

static void splash_entrance_timer_cb(lv_timer_t *timer)
{
  LV_UNUSED(timer);
  if (s_entrance_timer)
  {
    lv_timer_del(s_entrance_timer);
    s_entrance_timer = NULL;
  }
  thermostat_entrance_anim_start();
}

static void splash_start_exit_sequence(thermostat_splash_t *splash)
{
  if (!splash || splash->screen_fading)
  {
    return;
  }

  splash->screen_fading = true;

  if (!splash->screen)
  {
    s_active_splash = NULL;
    free(splash);
    return;
  }

  lv_obj_t *splash_screen = splash->screen;

  if (lock_lvgl() != ESP_OK)
  {
    ESP_LOGW(TAG, "splash_start_exit_sequence: LVGL lock failed; will retry");
    splash->screen_fading = false;
    lv_timer_create(splash_retry_exit_cb, SPLASH_EXIT_RETRY_DELAY_MS, splash);
    return;
  }

  lv_obj_t *new_screen = splash->pending_screen ? splash->pending_screen : lv_scr_act();
  lv_scr_load(splash_screen);

  // Animate transition: fade out splash, reveal new screen underneath
  // auto_del=true means LVGL will delete splash_screen when animation completes
  lv_scr_load_anim(new_screen,
                   LV_SCR_LOAD_ANIM_FADE_OUT,
                   THERMOSTAT_ANIM_SPLASH_FADE_OUT_MS,
                   0,
                   true);

  // Clear our references since LVGL will handle deletion via auto_del
  splash->screen = NULL;
  splash->stack = NULL;
  splash->pending_screen = NULL;
  for (uint8_t i = 0; i < SPLASH_HISTORY_COUNT; ++i)
  {
    splash->rows[i] = NULL;
  }

  splash_schedule_entrance_start();

  unlock_lvgl();

  // Free the splash context (screen will be freed by LVGL after animation)
  s_active_splash = NULL;
  free(splash);
}

static void splash_retry_exit_cb(lv_timer_t *timer)
{
  static uint32_t retry_count = 0;
  thermostat_splash_t *splash = (thermostat_splash_t *)lv_timer_get_user_data(timer);
  lv_timer_del(timer);
  retry_count++;
  if (retry_count % SPLASH_EXIT_RETRY_WARN_EVERY == 0)
  {
    ESP_LOGW(TAG, "splash exit still blocked after %u retries", retry_count);
  }
  splash_begin_exit_if_ready(splash);
  if (splash && splash->screen_fading)
  {
    retry_count = 0;
  }
}

static bool splash_color_equal(lv_color_t a, lv_color_t b)
{
  return memcmp(&a, &b, sizeof(lv_color_t)) == 0;
}
