shyndman/esp-theoretical-thermostat/main/thermostat/audio_boot.c

#include "thermostat/audio_boot.h"

#include <stdbool.h>
#include <stddef.h>

#include "connectivity/time_sync.h"
#include "esp_check.h"
#include "esp_log.h"
#include "sdkconfig.h"
#include "thermostat/application_cues.h"
#include "thermostat/audio_driver.h"
#include "thermostat/audio_personal.h"

static const char *TAG = "audio_boot";

#if CONFIG_THEO_AUDIO_ENABLE

extern const uint8_t sound_boot_chime[];
extern const size_t sound_boot_chime_len;
extern const uint8_t sound_failure[];
extern const size_t sound_failure_len;
extern const uint8_t sound_scott_greeting[];
extern const size_t sound_scott_greeting_len;

static bool s_prepared;

static esp_err_t ensure_driver_ready(void)
{
  esp_err_t err = thermostat_audio_driver_init();
  if (err != ESP_OK)
  {
    ESP_LOGW(TAG, "Audio driver init failed (%s)", esp_err_to_name(err));
  }
  return err;
}

static int clamp_volume_percent(int raw)
{
  if (raw < 0)
  {
    return 0;
  }
  if (raw > 100)
  {
    return 100;
  }
  return raw;
}

static esp_err_t apply_volume(void)
{
  int vol = clamp_volume_percent(CONFIG_THEO_BOOT_CHIME_VOLUME);
  esp_err_t err = thermostat_audio_driver_set_volume(vol);
  if (err != ESP_OK)
  {
    ESP_LOGW(TAG, "Failed to set speaker volume (%s)", esp_err_to_name(err));
    return err;
  }
  ESP_LOGI(TAG, "Speaker volume set to %d%%", vol);
  return ESP_OK;
}

static esp_err_t ensure_prepared(void)
{
  if (s_prepared)
  {
    return ESP_OK;
  }
  return thermostat_audio_boot_prepare();
}

static esp_err_t play_pcm_buffer(const char *cue_name, const uint8_t *buffer, size_t bytes)
{
  if (!buffer || bytes == 0)
  {
    ESP_LOGW(TAG, "%s asset invalid", cue_name ? cue_name : "Audio cue");
    return ESP_ERR_INVALID_SIZE;
  }

  esp_err_t policy = thermostat_application_cues_check(cue_name, CONFIG_THEO_AUDIO_ENABLE);
  if (policy != ESP_OK)
  {
    return policy;
  }

  ESP_RETURN_ON_ERROR(ensure_prepared(), TAG, "Audio driver not ready");
  esp_err_t err = thermostat_audio_driver_play(buffer, bytes);
  if (err != ESP_OK)
  {
    ESP_LOGW(TAG, "%s playback failed (%s)", cue_name ? cue_name : "Audio cue", esp_err_to_name(err));
    return err;
  }

  ESP_LOGI(TAG, "%s playback complete (%u bytes)", cue_name ? cue_name : "Audio cue", (unsigned)bytes);
  return ESP_OK;
}

esp_err_t thermostat_audio_boot_prepare(void)
{
  ESP_RETURN_ON_ERROR(ensure_driver_ready(), TAG, "Audio driver init failed");
  ESP_RETURN_ON_ERROR(apply_volume(), TAG, "Failed to set speaker volume");
  if (!s_prepared)
  {
    ESP_LOGI(TAG, "Speaker prepared for boot cues");
  }
  s_prepared = true;
  return ESP_OK;
}

esp_err_t thermostat_audio_boot_try_play(void)
{
#if !CONFIG_THEO_BOOT_CHIME_ENABLE
  ESP_LOGI(TAG, "Boot chime disabled via CONFIG_THEO_BOOT_CHIME_ENABLE");
  return ESP_OK;
#else
  return play_pcm_buffer("Boot chime", sound_boot_chime, sound_boot_chime_len);
#endif
}

esp_err_t thermostat_audio_boot_play_failure(void)
{
  return play_pcm_buffer("Failure tone", sound_failure, sound_failure_len);
}

esp_err_t thermostat_audio_personal_play_scott(void)
{
  return play_pcm_buffer("Scott greeting", sound_scott_greeting, sound_scott_greeting_len);
}

#else  // CONFIG_THEO_AUDIO_ENABLE

esp_err_t thermostat_audio_boot_prepare(void)
{
  ESP_LOGI(TAG, "Application audio disabled; speaker prep skipped");
  return ESP_ERR_INVALID_STATE;
}

esp_err_t thermostat_audio_boot_try_play(void)
{
  ESP_LOGI(TAG, "Boot chime suppressed: application audio disabled");
  return ESP_ERR_INVALID_STATE;
}

esp_err_t thermostat_audio_boot_play_failure(void)
{
  ESP_LOGI(TAG, "Failure tone suppressed: application audio disabled");
  return ESP_ERR_INVALID_STATE;
}

esp_err_t thermostat_audio_personal_play_scott(void)
{
  ESP_LOGI(TAG, "Scott greeting suppressed: application audio disabled");
  return ESP_ERR_INVALID_STATE;
}

#endif  // CONFIG_THEO_AUDIO_ENABLE
