shyndman/esp-theoretical-thermostat/(commit log)

2025-11-07 Add LCD configuration settings for ESP32P4
2025-11-07 Implement app_main functionality and update CMake configuration for ESP32-P4 display support
2025-11-07 Add thermostat UI header file with attachment function declaration
2025-11-07 Update LVGL configuration in sdkconfig.defaults and sdkconfig.defaults.esp32p4 for enhanced graphics support
2025-11-08 Update temperature display precision to one decimal place in weather and room groups
2025-11-08 Remove test from sample application
2025-11-08 Replace top bar fonts with tnum numerals
    [ui_top_bar.c]
2025-11-08 Position the fractional setpoint labels correctly
    [ui_setpoint_view.c]
2025-11-09 Fix all sorts of slop errors with fonts and colors
    [ui_actions.c]
2025-11-09 Add opacity support to the setpoint labels and track
2025-11-10 Snapshot the current touch behaviour
2025-11-10 Add backlight control, and the beginnings of anti-burn
    [backlight_manager.c, backlight_manager.h, ui_actions.c, ui_setpoint_input.c]
2025-11-10 Implement anti-burn and ignoring of the first tap
    [backlight_manager.c, backlight_manager.h, ui_actions.c, ui_setpoint_input.c]
2025-11-11 Wire up pre-commit to auto-initialize worktrees
2025-11-11 Eliminated the esp32p4 defaults file
2025-11-12 Fix the fan animation
    [ui_actions.c]
2025-11-12 Remove all of the fan animation frames
2025-11-12 Tweak the thermometer range to get out of the slop zone
    [ui_state.h]
2025-11-14 Add a new change request for LED effects
2025-11-14 I have validated the feature on-device
2025-11-14 Resolve a couple of copilot comments
    [remote_setpoint_controller.c]
2025-11-27 Change default pins to not be strapping pins
2025-11-27 Fix a couple incorrect constant names
    [audio_driver_max98357.c]
2025-11-29 Add dependency on the LED strip library
2025-11-29 Implement LED-based notifications
2025-11-29 Correct several mistakes identified in review
    [application_cues.c, thermostat_led_status.c, thermostat_leds.c]
2025-11-29 Change default LED to pin 33.
2025-11-29 Fix a number of issues with the implementation
    [application_cues.c, application_cues.h, thermostat_leds.c]
2025-11-29 Archive LED notification change
2025-11-29 Add a sparkling LED animation scratch
2025-11-29 Add a couple sensor change requests, for mm-wave radar and climate sensors
2025-11-29 Indicate the Firebeetle 2 is our new dev board
2025-12-03 Remove the non-existant EN pin from DAC
2025-12-05 Tighten up AGENTS.md
2025-12-05 Add a couple weather icons
2025-12-05 Implement support for temperature and humidity sensors
2025-12-06 Move I2C to different pins to get AH20 going
2025-12-06 Finish adding environment sensors
2025-12-06 Update LD2420 change spec with details frmo the sensors PR
2025-12-06 Add a couple logs
2025-12-06 Add a couple experiments for warming styles
2025-12-06 Expand the partition size
    [partitions.csv]
2025-12-08 Add a camera spec
2025-12-10 Add a couple of scratches for experimenting with LED effects
2025-12-10 Add weather icons (yet to be filtered down)
2025-12-11 Add updated I2C pins to defaults
2025-12-11 Add LED wave animation change proposal
2025-12-11 Add wave LED animations and MQTT command handling for effects
2025-12-11 Add new heating and cooling animations
2025-12-11 Add a couple new change proposals
2025-12-17 Set the default LED data pin to 49
2025-12-17 Add periodic logging of radar sensor data
2025-12-18 Implement a streaming camera service
2025-12-18 Stream camera frames successfully
2025-12-18 Improve the powered experience with a power button, and bias lighting
2025-12-18 Fix bugs reported in PR
    [thermostat_led_status.c]
2025-12-21 Archive improve power experience
2025-12-22 Increase the interval between env sensor printouts
2025-12-22 Flip the camera vertically
2025-12-22 Add clickability to the action buttons
2025-12-23 Further tighten up status line animations
    [ui_animation_timing.h]
2025-12-23 Replaced triple dots with ellipsis
    [ui_animation_timing.h, ui_splash.c]
2025-12-23 Correct the interaction between radar presence and the power button
    [backlight_manager.c, thermostat_leds.c, ui_animation_timing.h]
2026-01-16 Document sensors, streaming, and image tooling
2026-01-17 Pin esp_hosted to 2.8.0
2026-01-17 Add setpoint label displacement change proposal
    Add comprehensive OpenSpec proposal for horizontal label displacement
    feature to prevent finger occlusion during drag interactions.
    The proposal includes:
    - Complete implementation guide with function signatures and code
    - Verified API usage against LVGL 9.4 source and documentation
    - Detailed codebase context with line number references
    - 25 implementation tasks across 6 phases
    - 8 requirement scenarios covering all edge cases
    All assumptions verified against actual codebase:
    - Container and label structure (ui_setpoint_view.c)
    - Touch handling flow (ui_setpoint_input.c)
    - Animation patterns (ui_helpers.c, remote_setpoint_controller.c)
    - LVG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
2026-01-17 Propose vertical flip to correct camera orientation
2026-01-18 Propose on-demand camera streaming
    Document specs to ensure keyframes on connect.
2026-01-18 Add presence hold cap timeout
    Limit long presence wakes to protect the backlight and reset the cap on interaction.
    [backlight_manager.c]
2026-01-18 Archive create-stream-after-connect change
    Moves the change into the archive and aligns the camera-streaming spec with on-demand pipeline behavior.
2026-01-19 Track dependencies.lock for reproducible builds
2026-01-19 Add IR LED stream control proposal
2026-01-19 Enable OTA updates with UI feedback
    Add OTA HTTP endpoint, modal progress UI, and rollback validation. Update partitions and sdkconfig defaults (CONFIG_BOOTLOADER_APP_ROLLBACK_ENABLE, CONFIG_APP_ROLLBACK_ENABLE, CONFIG_THEO_OTA_PORT).
    [partitions.csv]
2026-01-19 Tie IR LED to stream lifecycle
    Enable the IR illuminator only while active streaming to reduce idle heat and power.
2026-01-19 Archive add-ir-led-stream
2026-01-19 Add device availability change proposal
2026-01-20 Report device availability via MQTT LWT
2026-01-20 Archive report-device-availability specs
2026-01-20 Align diagnostics discovery availability
    Document device-level availability so diagnostics follow LWT offline state.
2026-01-20 Add device telemetry sensors for diagnostics
    Publishes RSSI, chip temperature, free heap, and IP address as
    Home Assistant diagnostic sensors via MQTT auto-discovery.
2026-01-20 Archive add-device-diagnostics
2026-01-20 Implement anchor mode for setpoint label interactions
    Adds anchor mode to eliminate jump when clicking setpoint labels by providing proportional drag from touched temperature value. Clicking within setpoint containers now anchors to current temperature and updates proportionally based on vertical movement, preserving physical object illusion. All existing track clicking behavior remains unchanged. Increased main task stack size to prevent stack overflow during logging operations.
    [ui_setpoint_input.c, ui_setpoint_view.c, ui_setpoint_view.h, ui_state.h]
2026-01-21 Add camera flip controls
2026-01-21 Increase stack sizes for radar and sensor tasks to fix crashes
    [env_sensors.c, radar_presence.c]
2026-01-21 Fix invalid Home Assistant sensor device class for IP address
2026-01-21 Unify backlight fade behavior and fix quiet hours LED suppression
    [backlight_manager.c, thermostat_leds.c]
2026-01-21 Add colorize-camera-data spec
2026-01-22 Disable Nagle's algorithm on MJPEG stream server
    Set TCP_NODELAY and IP_TOS (IPTOS_LOWDELAY) on camera HTTP server
    sockets via open_fn callback to eliminate micro-stutters caused by
    Nagle buffering small HTTP chunks.
2026-01-22 Archive disable-camera-nagle change
2026-01-29 Vendor a number of dependencies that cannot be managed
    [partitions.csv]
2026-01-30 Switch WebRTC to WHEP responder
2026-02-02 Add a proposal for showing sysmon when I am on camera
2026-02-02 Update socket spec for WebRTC
2026-02-04 Add a couple wifi performance flags
2026-02-06 Change the number of buffers in the camera pipeline from 3 to 2
2026-02-06 Increase the amount of reserved SPI RAM, because we need it
2026-02-07 Propose boot without environmental sensors
2026-02-07 Refine proposal for missing env sensors
2026-02-09 feat(01-01): enforce single-slot MQTT reassembly bounds
    - Replace multi-slot dynamic reassembly with one active bounded flow
    - Enforce 1024-byte payload cap, 120-byte topic cap, and PSRAM payload storage
    - Apply deterministic drop taxonomy and freshness-first preemption without timeout recovery
2026-02-09 feat(01-01): add minute MQTT digest accounting contract
    - Expose periodic dataplane tick API for external wall-clock cadence triggering
    - Emit always-on 60s structured digest with cumulative and delta counters
    - Include queue_full and preempted flow totals/deltas in every digest line
2026-02-09 docs(01-01): wire digest tick and add phase-one test matrix
    - Piggyback dataplane periodic tick on existing heap monitor timer callback
    - Add manual verification cases for all required drop reasons and heartbeat digest behavior
2026-02-10 feat(02-01): add runtime health sampling core\n\n- Create runtime_health module with fixed stack probe slots and internal-RAM heap snapshots\n- Implement WARN/CRIT threshold engine with hysteresis an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
2026-02-10 feat(02-01): expose stack probe hooks for core tasks\n\n- Add dataplane and sensor task handle/stack size getter APIs for runtime probes\n- Record radar-start task stack watermark before task self-de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
2026-02-10 feat(02-01): wire runtime health to existing periodic cadence\n\n- Initialize runtime health during boot before starting heap monitor timer\n- Run runtime health periodic sampling in heap_log_timer_c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
2026-02-10 feat(02-stack-and-heap-observability-02): integrate webrtc worker runtime-health probe
    - add webrtc worker handle/stack getter APIs for enabled and disabled builds
    - configure runtime_health to register webrtc worker probe when stack metadata is available
2026-02-10 feat(02.1-01): add periodic RAM attribution buckets\n\n- extend runtime_health periodic logs with parseable RAM budget buckets and ratios\n- attribute dynamic allocation churn deltas from webrtc_stre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
2026-02-10 feat(02.1-01): add default-off WebRTC wave1 gate\n\n- introduce CONFIG_THEO_RAM_WAVE1_WEBRTC_TUNING with explicit default-n policy\n- keep wave1 flag disabled in sdkconfig defaults to preserve baseli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
2026-02-28 fix(camera-streaming): harden WHEP terminal handling
    Ensure each WHEP request reaches a single terminal completion path instead of hanging on early failures or stop races. Bound stalled offer-body reads, make pre-answer signaling fail fast on invalid terminal messages, and add explicit terminal-reason logging tokens in the stream worker for diagnosis. Validation: idf.py build.
2026-02-28 docs(camera-streaming): align media profile with 800x800@5fps
2026-03-16 feat(quiet-hours): dim LED output during quiet hours
    Quiet hours now keep LED effects running at 25% brightness instead of suppressing them, so boot, HVAC, and greeting animations remain visible but less intrusive. Audio cues still use the existing suppression contract, while LED callers now consult thermostat_application_cues_quiet_hours_active() and apply the brightness policy centrally in the LED write path.
2026-03-22 fix(mqtt): republish entity availability on reconnect
    Home Assistant now recovers environmental and radar entities after late broker connects or reconnects instead of leaving them stuck unavailable while state topics continue updating. Device availability remains tied to the thermostat LWT topic, while environmental and radar failures only flip their own per-entity availability topics and cached retained state is republished on MQTT connect.
    [env_sensors.c, radar_presence.c]
2026-03-23 feat(mqtt): mirror logs over MQTT
    The thermostat now mirrors later boot and runtime UART log lines to <theo_base>/<device_slug>/logs so wall-mounted debugging no longer depends on a serial cable. Shared device identity now initializes before MQTT startup, and all MQTT-facing publishers consume that single source of truth for slug, friendly name, and Theo base topic.\n\nThe mirror keeps UART as the primary sink, reuses the existing MQTT client/outbox, and publishes best-effort with QoS 0 enqueue semantics. MQTT outbox data is configured for external memory and bounded in code so disconnects do not create an unbounded internal-memory backlog.
    [env_sensors.c, env_sensors.h]
2026-03-24 feat(scripts): add MQTT log tail helper
    Developers can now tail mirrored thermostat logs from their dev machine with scripts/theotail.py instead of keeping a serial monitor attached. The script runs under uv, reads broker defaults from repo sdkconfig files unless CLI flags override them, and subscribes over MQTT/WebSockets to <theo_base>/<device_slug>/logs unless --topic is set.
2026-03-24 feat: add calibration
2026-03-24 feat(radar): dump thresholds on command
    The thermostat now accepts a radar_dump_thresholds command on its existing MQTT command topic and logs the current LD2410 thresholds, gate ranges, and live per-gate energies for calibration work. The radar task and command path now serialize LD2410 access behind the radar state mutex, and the command returns warnings instead of partial output when the radar is offline, disabled, or busy.
2026-03-25 feat(ota): add OTA lifecycle logging
    OTA uploads now emit clear lifecycle logs for request admission, progress milestones, UI modal state, and reboot handoff so operators can see what the device is doing during an update. Progress logging is bucketed at 10% intervals to avoid log spam while still making stalled or partial uploads obvious.\n\nThe OTA server/UI contract is unchanged: uploads still use POST /ota with the existing callback flow, backlight hold behavior, and modal updates, but those transitions are now logged explicitly.
    [ui_ota_modal.c]
2026-03-26 feat(radar): add MQTT calibration command
    The thermostat now accepts radar_calibrate on the Theo command topic and forwards it into the radar subsystem so operators can start LD2410 auto-threshold calibration without reflashing. The command remains fire-and-forget: the dataplane logs receipt, the radar module launches ld2410_auto_thresholds(..., 10) under its existing mutex boundary, and no completion or status reporting is added.
2026-04-05 fix(backlight): avoid retriggering antiburn in one schedule window
    Scheduled antiburn stopped after its duration timer, then immediately restarted on the next schedule tick while the configured window was still open. That made a single schedule window loop pixel training over and over until the window closed.\n\nTrack whether the current schedule window has already been consumed and only arm scheduled antiburn once per window. Reset that flag when the window ends so the next scheduled window still starts normally.
    [backlight_manager.c]
2026-04-05 feat(mqtt): add an antiburn command
    MQTT command payloads now accept "antiburn", which starts the backlight pixel-training overlay without waiting for the scheduled window. Repeated requests restart the antiburn timer instead of being ignored, so the command works even if antiburn is already active.
    The dataplane calls a dedicated backlight_manager_trigger_antiburn() entry point, and command-triggered runs are capped at 10 seconds while consuming the current schedule window to avoid an immediate scheduled rerun.
    [backlight_manager.c, backlight_manager.h]
2026-04-05 fix: update thermostat UI temperature range
    [ui_state.h]
2026-04-05 fix(ui): nudge top bar icons upward
    The top bar weather and room icons sat one pixel low relative to their temperature labels, which made the alignment look off even though the flex layout was correct.
    Apply a 1px negative Y translate to each icon in ui_top_bar so the rendered glyph moves up without changing padding, widths, or top bar layout behavior.
    [ui_top_bar.c]
2026-04-05 fix(ui): shorten startup splash errors
    Startup boot failures formatted splash errors as "Failed to <stage>: <err>", and the clipped err_name often disappeared, leaving a stray trailing colon on screen. Update the splash formatter to show only "Failed to <stage>" while keeping the full stage and esp_err_to_name detail in boot_fail() logs for debugging.
    [ui_splash.c]
2026-04-05 fix(ui): align top bar room and weather rows
    The top bar room icon assets were 47x47 while the weather icons were 48x48, which left the two flex groups on different vertical centers and produced a persistent 1px mismatch between the room and weather rows.
    Pad the room icon assets to 48x48 so both sides share the same icon box size, then keep the weather and room groups top-aligned with the temperature labels translated down 12px and icons left at zero offset.
    [ui_top_bar.c]
2026-04-05 fix(ui): extend setpoint stripe anchor tails
    Touches slightly below a setpoint stripe were still routed as absolute touches, so anchor-relative drags only worked when the press landed directly on the visible stripe. Extend each live stripe with a 60 px downward tail for anchor-mode hit testing, keep real stripe hits higher priority than tail matches, and resolve overlapping tails by choosing the nearest stripe body.
    [ui_setpoint_input.c]
2026-04-06 fix(probe): rewrite browser host candidates
    theoprobe now accepts a manual browser IP override and rewrites browser host candidates before posting the SDP offer to the thermostat. This replaces mDNS host addresses with the supplied IPv4 address and drops host TCP candidates so the short-lived probe can drive LAN ICE negotiation with numeric UDP candidates.
2026-04-06 fix(logging): quiet temporary WHEP debug mode
    Temporary WebRTC WHEP debugging was drowning useful connection logs under ISP spam and repeated `mqtt_log_mirror` enqueue failures. In that mode, clamp camera-driver tags down, silence the ISP tag entirely, and skip starting the MQTT log mirror so serial WHEP diagnostics stay readable while the temporary debug profile is active.
2026-04-06 fix(probe): default browser IP override
    theoprobe now pre-fills the browser IP override with Scott's static workstation address so the host-candidate rewrite path is ready on page load. It also escapes the generated `\r\n` delimiters in the inline rewrite helper so the page no longer throws "Uncaught SyntaxError: '' string literal contains an unescaped line break" before posting the SDP offer.
2026-04-06 fix(logging): keep PEER_DEF startup logs verbose
    webrtc_stream_start was clamping PEER_DEF back to error on first startup, which hid the peer_default ICE and DTLS logs that the temporary WHEP debug profile depends on. Keep that tag at verbose when the stream module starts so the connection bring-up path stays observable.
2026-04-06 fix(ui): widen action hit targets and restore 25C max
    The thermostat action icons were too small to tap reliably, and the setpoint ceiling stopped at 24C even though the UI expects a 25C top end. Add an extended click area for the mode, power, and fan icons, and raise THERMOSTAT_MAX_TEMP_C back to 25.0f.
    [ui_actions.c, ui_state.h]
2026-04-12 fix(mqtt): make device availability reconnect reliably
    Home Assistant could keep the thermostat offline because the retained shared topic theostat/<slug>/availability only published online once after reconnect, leaving the last-will offline payload stuck on the broker if that publish was missed.
    Switch the shared availability topic to retained QoS1, track the pending online publish by MQTT msg_id, and retry it on a timer until MQTT_EVENT_PUBLISHED confirms the broker ack so reconnects always heal the stale retained offline state.
2026-04-22 fix(mqtt): scope Theo topics under device root
    Theo-owned MQTT topics mixed shared and device-scoped paths, so commands and telemetry no longer shared one coherent contract and the discovery helper still hardcoded a raw Home Assistant prefix. Move Theo-authored topics under the canonical `<TheoBase>/<slug>` root, normalize `CONFIG_THEO_HA_BASE_TOPIC` for discovery topic generation, and update the Kconfig/manual test docs to match the new topic shapes.
    [env_sensors.c]
2026-04-23 refactor(backlight): remove anti-burn support
    Remove the anti-burn MQTT command, runtime timers, and snow overlay so the backlight manager only handles idle, daypart, and hold behavior. This deletes the public anti-burn API and Kconfig/sdkconfig knobs, so `antiburn` now falls through as an unknown command and no anti-burn config entries remain.
    [backlight_manager.c, backlight_manager.h]
2026-04-23 fix(lsp): strip esp-idf clangd noise
    clangd was reading the ESP-IDF compile_commands.json and reporting drv_unknown_argument errors on every C/C++ write for -fstrict-volatile-bitfields and -fno-tree-switch-conversion. Add a project .clangd that removes those GCC-only flags before parsing and ignore the FreeRTOS.h include-cleaner false positive, while dropping the redundant direct include in mqtt_dataplane.c.
2026-04-23 refactor(audio): remove bsp codec backend
    Speaker output now always targets the MAX98357 path whenever THEO_AUDIO_ENABLE is enabled, so the old BSP codec option is gone from menuconfig and the build. The audio driver contract stays the same for callers, but there is no longer any selectable audio backend; the esp32_p4_nano BSP remains only for non-audio services like display, backlight, and touch.
    [audio_boot.c, audio_driver_max98357.c]
2026-05-03 feat(camera): publish MQTT snapshots
    Thermostat now captures 800x800 grayscale JPEG snapshots and publishes them to <TheoBase>/<slug>/camera/snapshot every THEO_CAMERA_SNAPSHOT_INTERVAL_MS (default 500 ms) instead of serving WebRTC/WHEP video. The stream stack, microphone path, and vendored WebRTC/media components are removed; snapshots use QoS 0, PSRAM-backed buffers, aggregate publish timing logs every 30 attempts, and suppress esp_ipa* ISP chatter from UART and MQTT logs.
    [partitions.csv]
2026-05-03 feat(camera): add Home Assistant discovery
    Home Assistant now auto-discovers the MQTT snapshot camera instead of requiring manual camera setup. The camera advertises discovery on the existing Home Assistant base, publishes retained snapshots on <TheoBase>/<slug>/camera/snapshot, and exposes retained online/offline state on <TheoBase>/<slug>/camera/availability.
